AndingDrLin/TDPS/docs/line_following.md

# 巡线子系统设计（line_follow_v1）

本文档描述当前仓库中巡线系统的实现方案。重点是“为什么这样做”和“代码边界在哪里”。

## 1. 设计目标

- 在常见扰动下保持持续压线
- 丢线后可恢复，不进入无限振荡
- 关键参数可集中调节
- 可通过离线场景批量回归

## 2. 关键实现

### 2.1 传感器处理

- 传感器数量：8 路（默认）
- 输入模式由 `sensor_input_mode` 选择，支持 ADC、GPIO 数字量和 Yahboom 8-LP UART 协议路径
- 先做归一化，再做低通滤波
- 采用配置权重计算位置偏差；debug profile 因 Yahboom UART 实车通道顺序使用 `{1750..-1750}` 权重，方向以实车架空验证为准
- 输出辅助信号：`signal_sum`、`peak_value`、`contrast_value`、`active_count`、`line_confidence`、`edge_hint`

与 Yahboom 8-LP 的接口匹配策略：

- UART 模式：当前默认 debug profile 使用 `LF_SENSOR_INPUT_UART_PROTOCOL`。
- GPIO 模式：通过 `LF_SENSOR_INPUT_DIGITAL_GPIO` 读取 8 路高低电平。
- ADC 模式：保留 `LF_SENSOR_INPUT_ANALOG_ADC` 路径。
- 极性通过配置解决：
	- `sensor_digital_active_high`（数字模式）
	- `sensor_invert_polarity`（模拟/UART 归一化后翻转）

相关文件：

- `Src/lf_sensor.c`
- `Inc/lf_sensor.h`
- `Src/lf_config.c`（权重和阈值）

### 2.2 控制器

- 控制器类型：**PD + 曲率前馈(kff)**（`TDPS_SIMPLE_CONTROL=1`，6 参数）
- 核心公式：`correction = kp*error + kd*derivative + kff*derivative*speed`
- 速度公式：`speed = base_speed - (base_speed - min_speed) * |error| / 1750`（连续函数 + IIR 平滑 alpha=0.4）
- 底盘命令：`left = speed + correction`，`right = speed - correction`
- `correction > 0` 时左轮更快、右轮更慢，车向右修正；`correction < 0` 时向左修正
- 对输出和电机命令做限幅，避免打满
- 与旧架构差异：无死区/软区/积分/速度缩放/变化率限幅/二重滤波；速度由连续函数决定而非 6 级优先级链

相关文件：

- `Src/lf_control.c`
- `Src/lf_chassis.c`

### 2.3 状态机

状态定义：`WAIT_START -> CALIBRATING -> RUNNING -> RECOVERING / AVOID_* -> STOPPED`

核心行为：

- `CALIBRATING`：左右摆动采样，提高 min/max 覆盖度
- `RUNNING`：按固定周期读传感器 + 更新 PD + kff（简化模式）
- `RUNNING`：连续速度函数自动调节快慢（straight_boost/curve_prepare 已关闭）
- `RUNNING`：识别直线脏点、地图褶皱和反光造成的弱异常帧，通过 `straight_noise_*` 避免误触发弯前减速
- `RUNNING`：识别宽黑、T 字、直角、圆形入口、U 型顶点等特殊线型，通过 `lead_compensation` 先低速直行补偿，再按入口方向保持转向
- `RUNNING`：识别宽黑/箭头类干扰帧，避免单帧跳变污染恢复方向或立即触发岔路
- `RUNNING`：并行轮询雷达状态（非阻塞），`WARN` 减速，`BLOCK` 进入避障
- `RECOVERING`：按可信的最后看到线方向搜索；若遇到 `BLOCK` 也进入避障
- `AVOID_*`：停车确认、转出、弧线绕行、转回、低速找线；失败后反向重试
- 超时或重试失败进入 `STOPPED`，避免失控持续运行

相关文件：

- `Src/lf_app.c`
- `Inc/lf_app.h`

## 3. 参数策略

参数集中在 `Src/lf_config.c` 的 `g_lf_config`。当前实车默认启动路径会调用 `LF_Config_ApplyDebugProfile()`，所以上板低速验证以 `Src/lf_config_profiles.c` 的 debug profile 覆盖值为准；默认结构体值主要作为未套 profile 或 competition profile 的基线。逐项含义和整车调试方法见 `docs/tuning.md`。

建议顺序：

1. 传感器极性、通道顺序和 `sensor_weights`
2. 6 核心参数：`base_speed` → `kp` → `kd` → `kff` → `min_speed` → `max_correction`
3. `straight_noise_*`
4. `lead_advance_ticks`
5. `lead_turn_delta` / `lead_turn_hold_ticks`
8. `lead_event_confirm_ticks` / `lead_event_min_sum` / `lead_event_active_count_threshold`
9. `line_detect_min_sum` / `line_detect_min_peak` / `line_detect_min_contrast`
10. `interference_active_count_threshold` / `interference_position_jump_threshold`
11. `line_hold_speed` / `line_hold_turn_speed` / `recover_timeout_ms`
12. `obstacle_turn_out_ms` / `obstacle_bypass_ms` / `obstacle_turn_in_ms`
13. `obstacle_reacquire_timeout_ms` / `obstacle_preferred_side`

8-LP 相关关键参数：

- `sensor_input_mode`
- `sensor_digital_threshold`
- `sensor_digital_active_high`
- `sensor_invert_polarity`
- `sensor_use_dynamic_calibration`

调参要求：

- 一次只改少量参数
- 每次改动记录场景、参数、结果
- 调参结论以离线报告为准，不靠主观印象

## 4. 离线回归方法

默认场景配置：`simulator/sim_tests/line_follow_v1/config/scenarios_default.csv`

覆盖类型：

- 基线场景（circle/figure8/patio）
- 初始偏置（left/right offset）
- 传感器噪声、掉线、增益/偏置误差
- 电机不一致、一阶惯性、低速非线性、电池压降
- 传感器安装偏差、线宽变化
- 雷达延迟、漏检、误检、距离抖动
- 组合压力场景

门禁规则由 harness 固化：

- quick：`82 / 0.94 / 0.35 / min_scenario_score=70`
- full-course：完整赛道需按顺序触发检查点、到达终点、无碰撞/越界，并满足进度与丢线门限
- stability：`80 / 93% / 0.40s`

当前 track 相关 quick 回归结果：手动用当前 `simulator/` 路径构建 runner 后，`quick` normal 16 个场景整体 `95.41/100`、平均检测率 `100.00%`、最大丢线 `0.000s`、Confidence `High`。注意：部分脚本仍引用旧 `TDPS-Simulator/` 路径，必要时按 `agent_docs/03_agent_working_notes.md` 说明手动使用当前路径。

## 5. 扩展接口

`lf_future_hooks` 提供弱符号空实现，用于后续接入：

- LoRa 窗口触发
- 雷达窗口触发
- 标定开始/结束事件
- 丢线/复线事件

约束：扩展逻辑不得直接破坏 `LF_App_RunStep` 的周期语义。

## 6. 已知限制

- 当前三轮差速车传感器阵列中心到左右驱动轮轴线中点约 22 cm，左右驱动轮中心距约 16 cm；路口、U 型顶点、直角和圆形入口应以驱动轮轴线中点作为实际转向参考点
- `lead_advance_ticks` 目前是时间近似，不是编码器闭环距离；换速度、电池、电机或地面摩擦后，需要重新校准“传感器看到特殊线型后继续前进多远”
- 雷达解析已支持保留测试帧、LD2410S 最小帧和已知标准帧目标/距离字段，仍需实机确认距离单位、波特率和目标状态语义
- 当前避障只有前向雷达信息，不能直接感知障碍在左侧还是右侧；左右绕行依赖配置、上次线方向和失败反向重试
- 避障动作是定时开环，换电池、电机、地面摩擦或车体负载后必须重新调参
- `LF_Config_ApplyDebugProfile()` 是默认启动配置，使用低速保守参数；`LF_Config_ApplyCompetitionProfile()` 仅在明确切换时用于比赛参数。
