AndingDrLin/TDPS/reports/final_report/team_15_final_pre.pdf

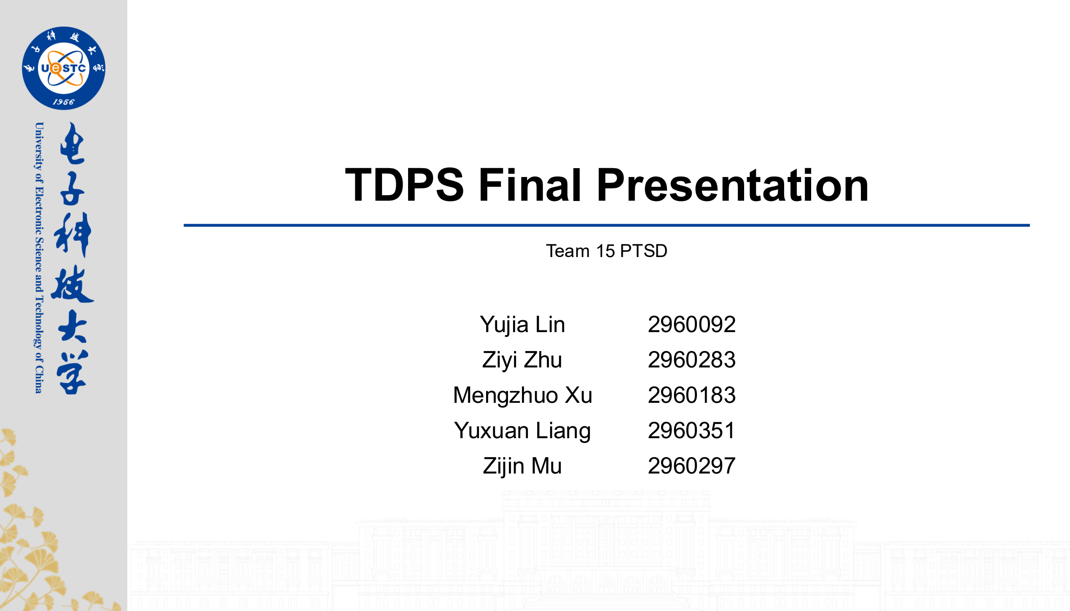
[picture p1: page 1]

# TDPS Final Presentation

Yujia Lin | 2960092
Ziyi Zhu | 2960283
Mengzhuo Xu | 2960183
Yuxuan Liang | 2960351
Zijin Mu | 2960297

Team 15 PTSD

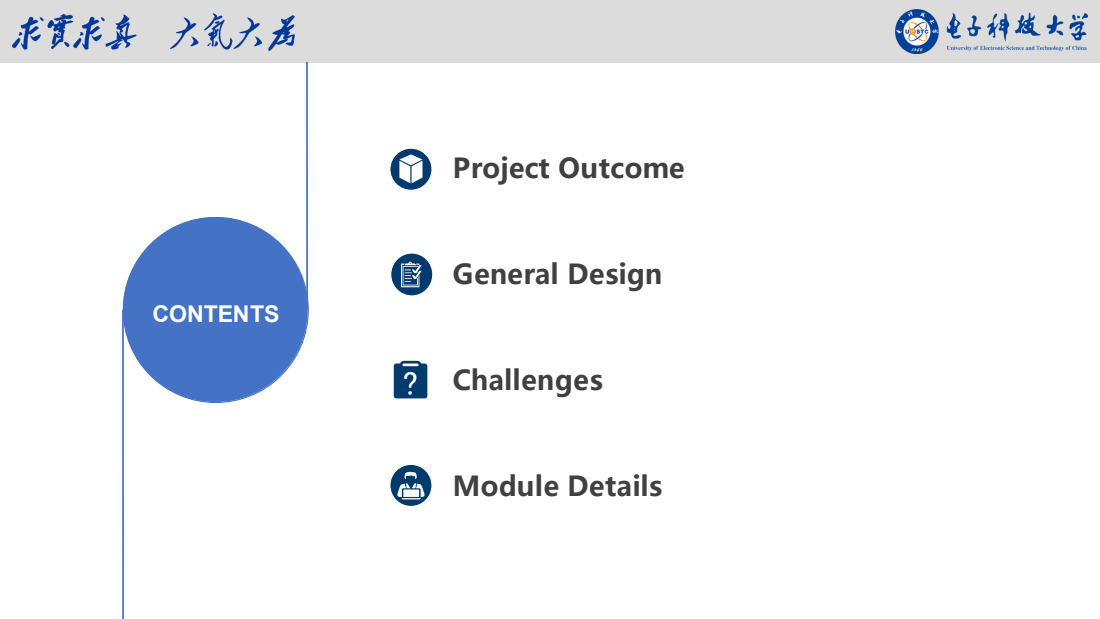
[picture p2: page 2]
CONTENTS; General Design; Project Outcome; Challenges; Module Details

# Project Outcome

## Final Demo Results:

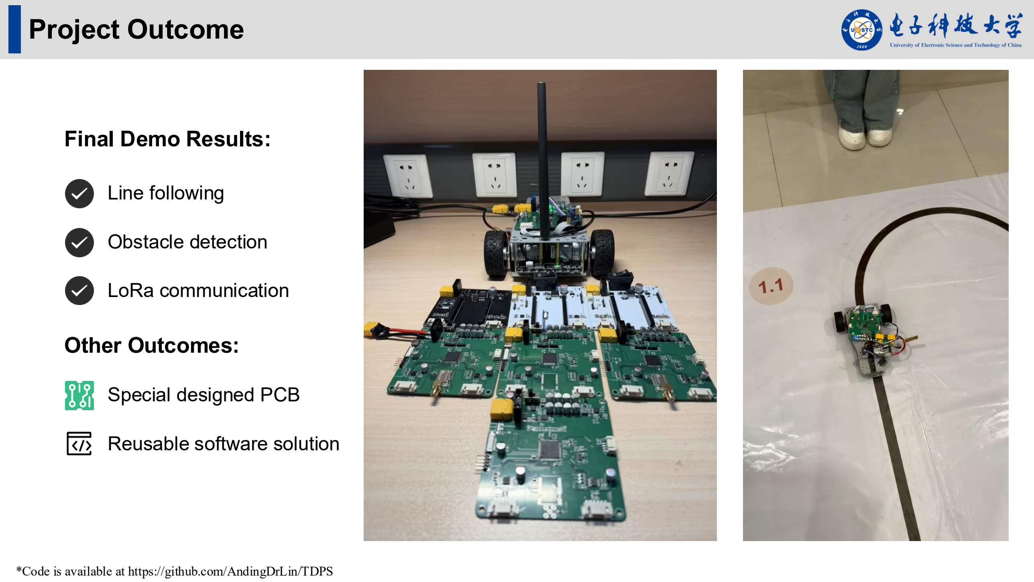
[picture p3: page 3]

## Line following

## Obstacle detection

## LoRa communication

## Other Outcomes:

## Special designed PCB

## Reusable software solution

*Code is available at https://github.com/AndingDrLin/TDPS

# Hardware Platform

## Chassis Selection:

## - Differential tricycle: easy to design and test

## - Inverted tricycle: more flexible but not stable

## - Forward tricycle: very hard to finish line following

## PCB Design:

- Adapter board: easy to design,

## low reliability, problems with power supply

- Integrated PCB: much smaller,

## more stable, much better power supply

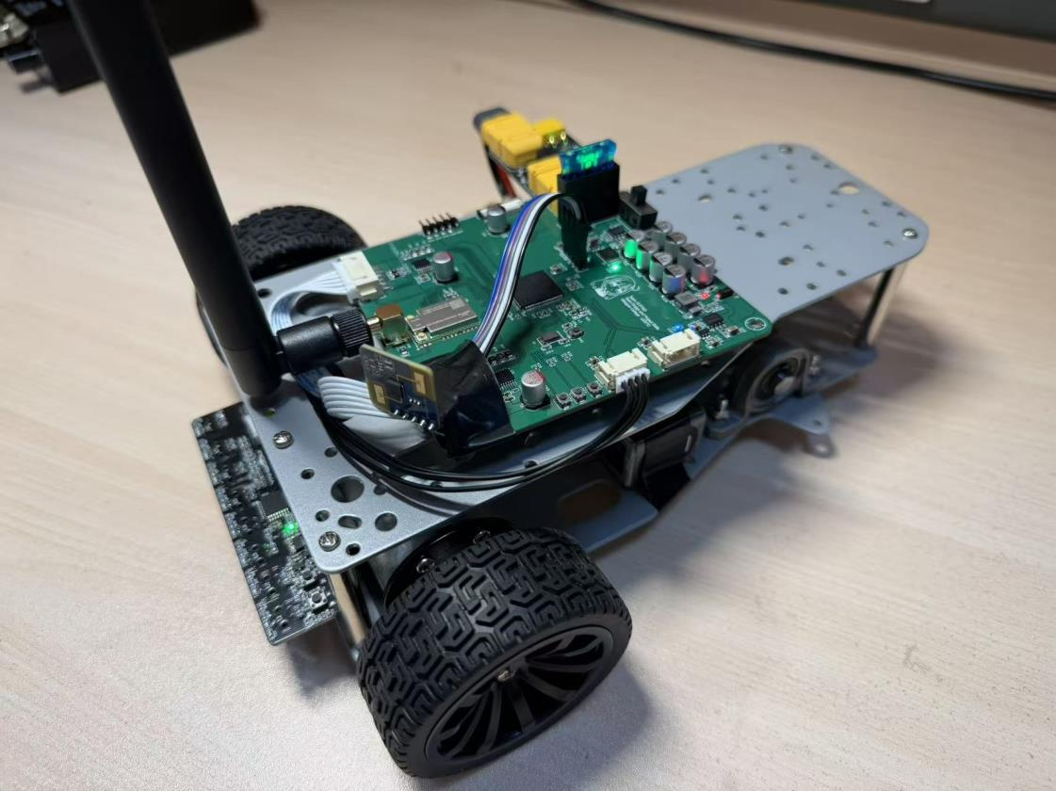
[picture p4: figure]

Module | Type
Line-following Sensor | Yahboom 8-LP Sensor
LoRa Module | EWT22A-900BWL22S
Radar | HLK-LD2410S
MCU | STM32F407VET6

## Software Architecture

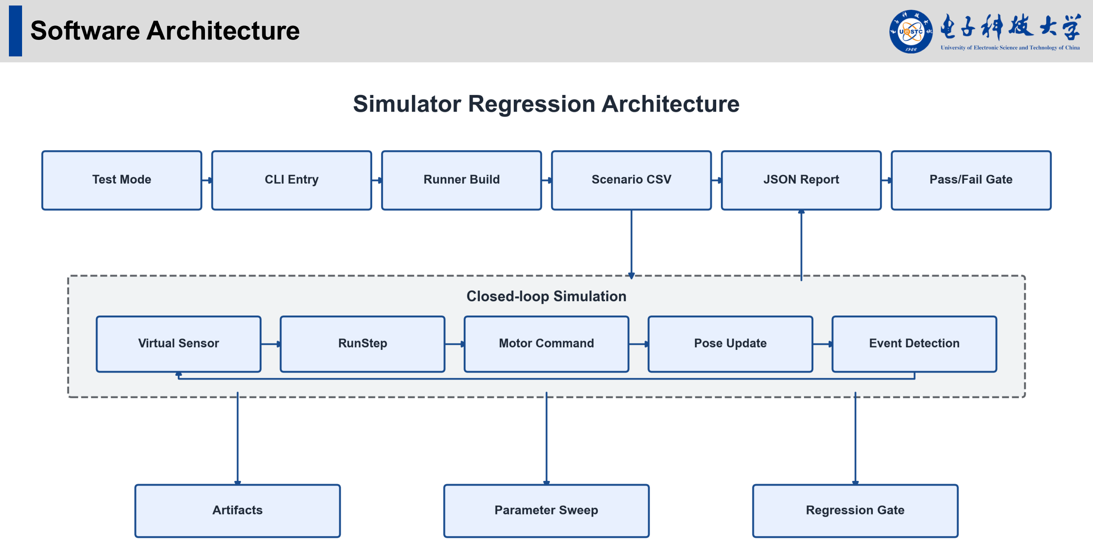
[picture p5: page 5]

## Challenges and Insight

## Challenges:

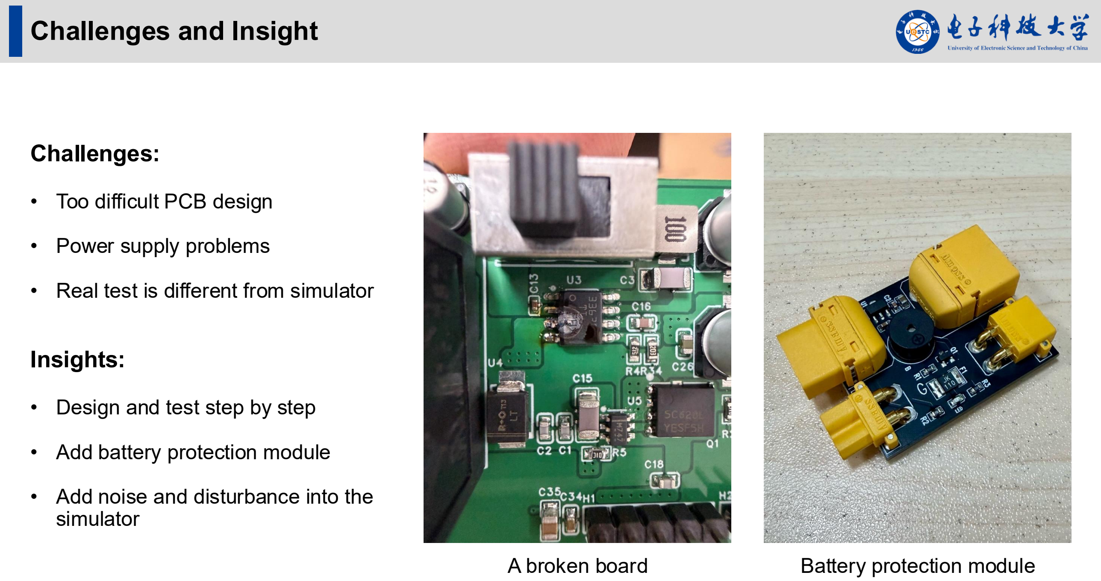
[picture p6: page 6]

## - Too difficult PCB design

## - Power supply problems

## - Real test is different from simulator

## Insights:

## - Design and test step by step

## - Add battery protection module

## - Add noise and disturbance into the simulator

A broken board | Battery protection module

## Core Requirements

## ① Design Objective

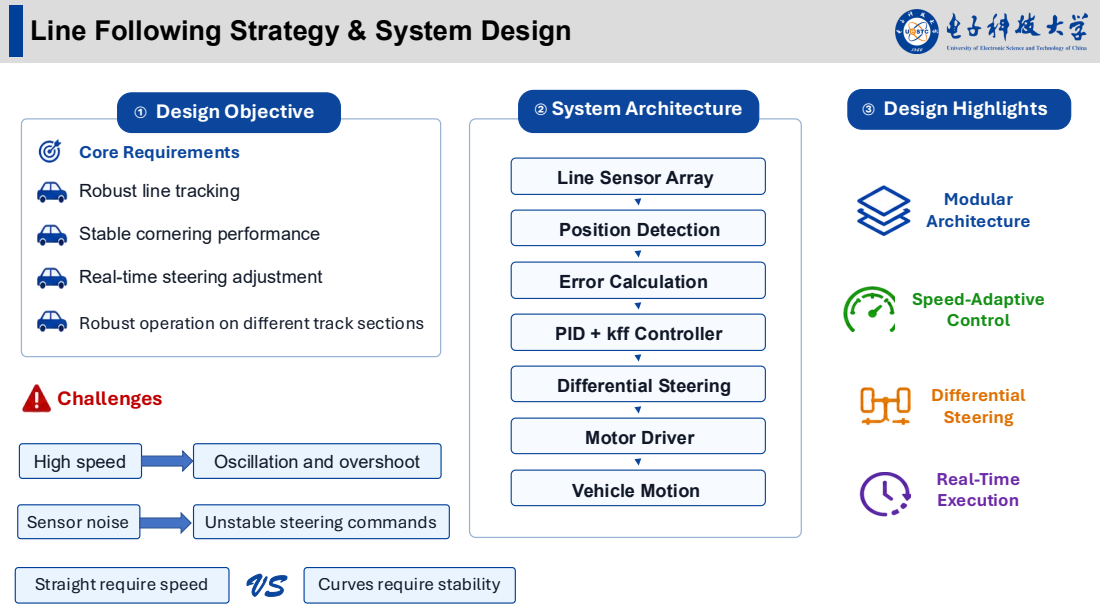
[picture p7: page 7]
Challenges; High speed; Sensor noise; ② System Architecture; Position Detection; Error Calculation; Differential Steering; Motor Driver; Vehicle Motion; ③ Design Highlights; Modular Architecture; Speed-Adaptive Control; Real-Time Execution

Line Following Strategy & System Design

Line Sensor Array

Robust line tracking

Stable cornering performance

Real-time steering adjustment
Robust operation on different track sections

PID + kff Controller

Oscillation and overshoot

Unstable steering commands

Straight require speed

Curves require stability

# PD+kff Control Implementation

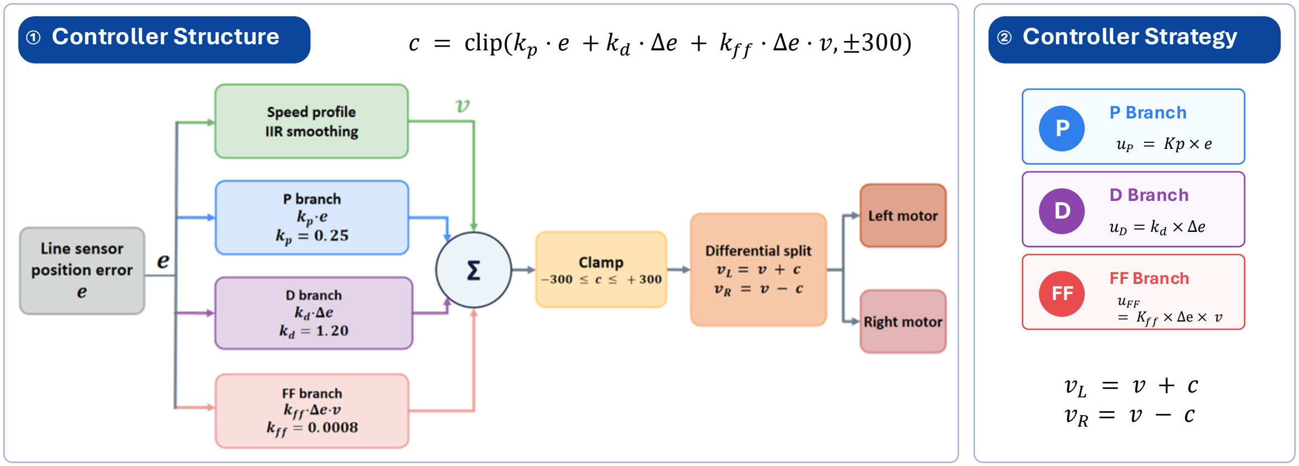
[picture p8: figure]
P Branch; D Branch; FF Branch; uFF = Kff × Δe × v

① Controller Structure | ② Controller Strategy

## c = clip(kp · e + kd · Δe + kff · Δe · v, ±300)

## ③ Why PD+kff ?

Control Method | Characteristics
P Only | Fast but oscillatory
PD | Stable but slower
PD+kff | Fast and stable

Achieved Benefits

✓ Reduced oscillation

✓ Faster response

✓ Smooth cornering

✓ Stable high-speed line tracking

## NON-BLOCKING TECHNICAL ROUTE

# Radar Subsystem: Technical Route & Architecture

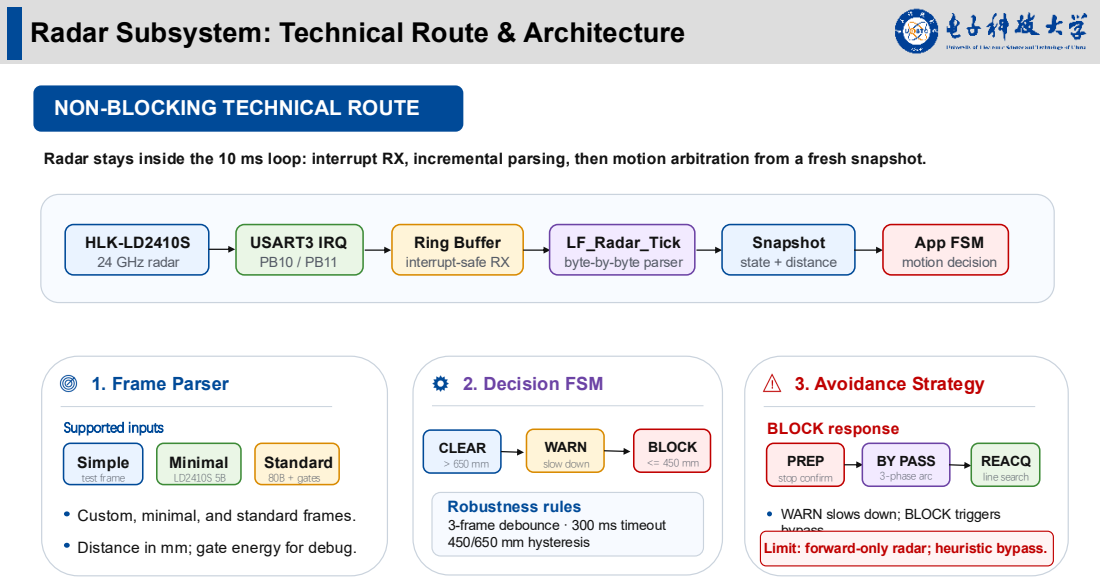
[picture p9: page 9]
HLK-LD2410S; 24 GHz radar; USART3 IRQ; Snapshot; state + distance; App FSM; motion decision; 1. Frame Parser; Supported inputs; Simple test frame; Minimal LD2410S 5B; Standard 80B + gates; 2. Decision FSM; CLEAR > 650 mm; WARN slow down; BLOCK <= 450 mm; 3. Avoidance Strategy; BLOCK response; PREP stop confirm; BY PASS 3-phase arc; REACQ line search

Radar stays inside the 10 ms loop: interrupt RX, incremental parsing, then motion arbitration from a fresh snapshot.

Ring Buffer
interrupt-safe RX

LF_Radar_Tick
byte-by-byte parser

Robustness rules
3-frame debounce · 300 ms timeout
450/650 mm hysteresis

WARN slows down; BLOCK triggers
bypass.
Limit: forward-only radar; heuristic bypass.

Custom, minimal, and standard frames.

Distance in mm; gate energy for debug.

# PCB Integration: Power and Interfaces

# Initial PCB Design:

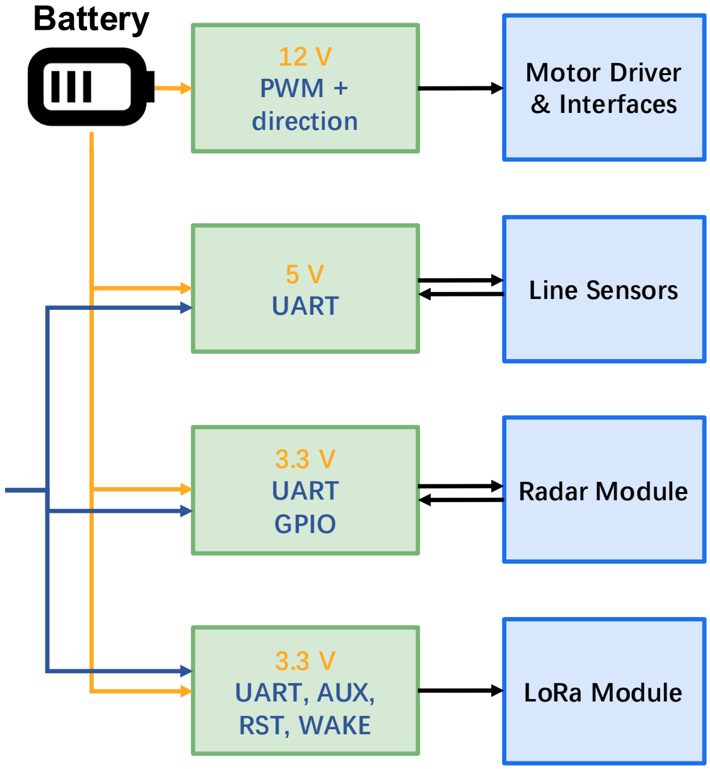
[picture p10: figure]
Motor Driver & Interfaces; Line Sensors; Radar Module; LoRa Module; 12 V PWM + direction; 5 V UART; 3.3 V UART GPIO; 3.3 V UART, AUX, RST, WAKE; Battery

## Adapter board + STM32F407VET6

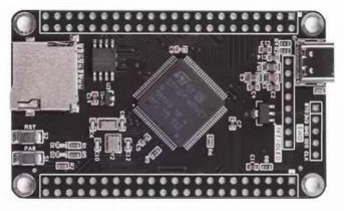
[picture p11: figure]

+

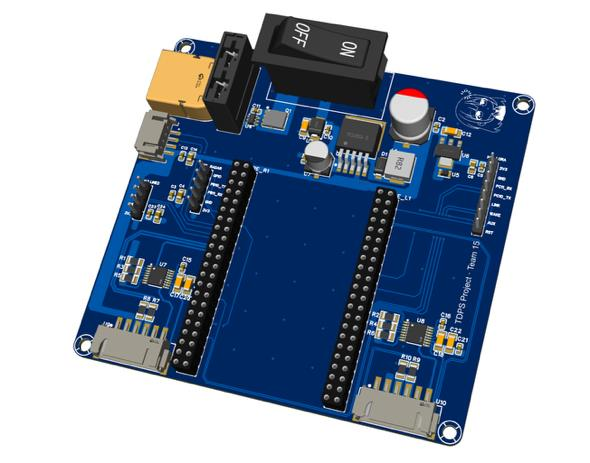
[picture p12: figure]

Limitation:

Loose and unreliable wiring | Poor power stability

## MCU

# Requirement Analysis

# PCB : Six Iterations to PCB6

# Different Versions and Iterations of PCB Design

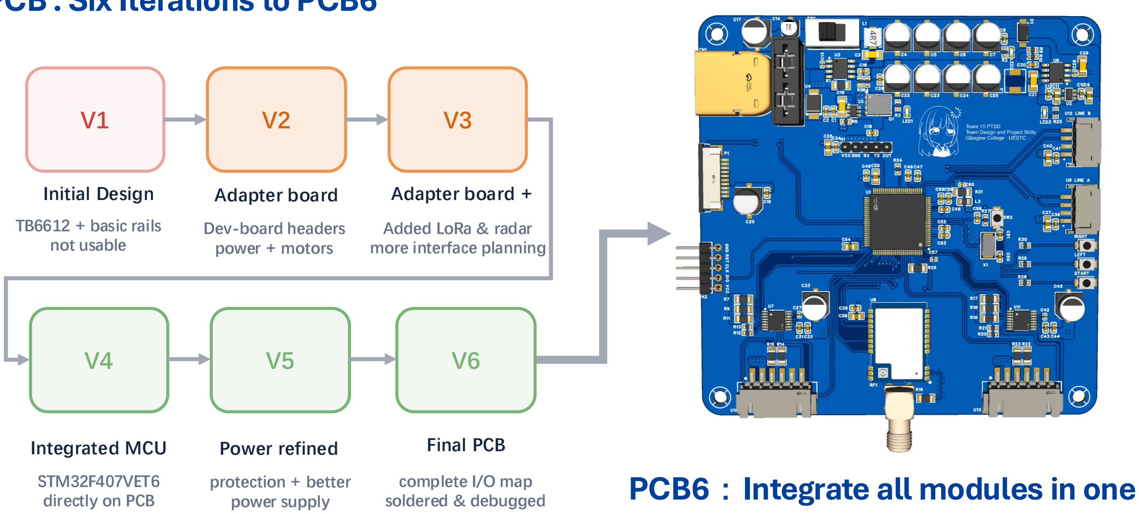
[picture p13: figure]
Adapter board; Dev-board headers power + motors; Added LoRa & radar more interface planning; STM32F407VET6 directly on PCB; complete I/O map soldered & debugged; Initial Design; TB6612 + basic rails not usable; Adapter board +; Integrated MCU; Power refined; protection + better power supply; Final PCB; PCB6：Integrate all modules in one

### Battery input and protection

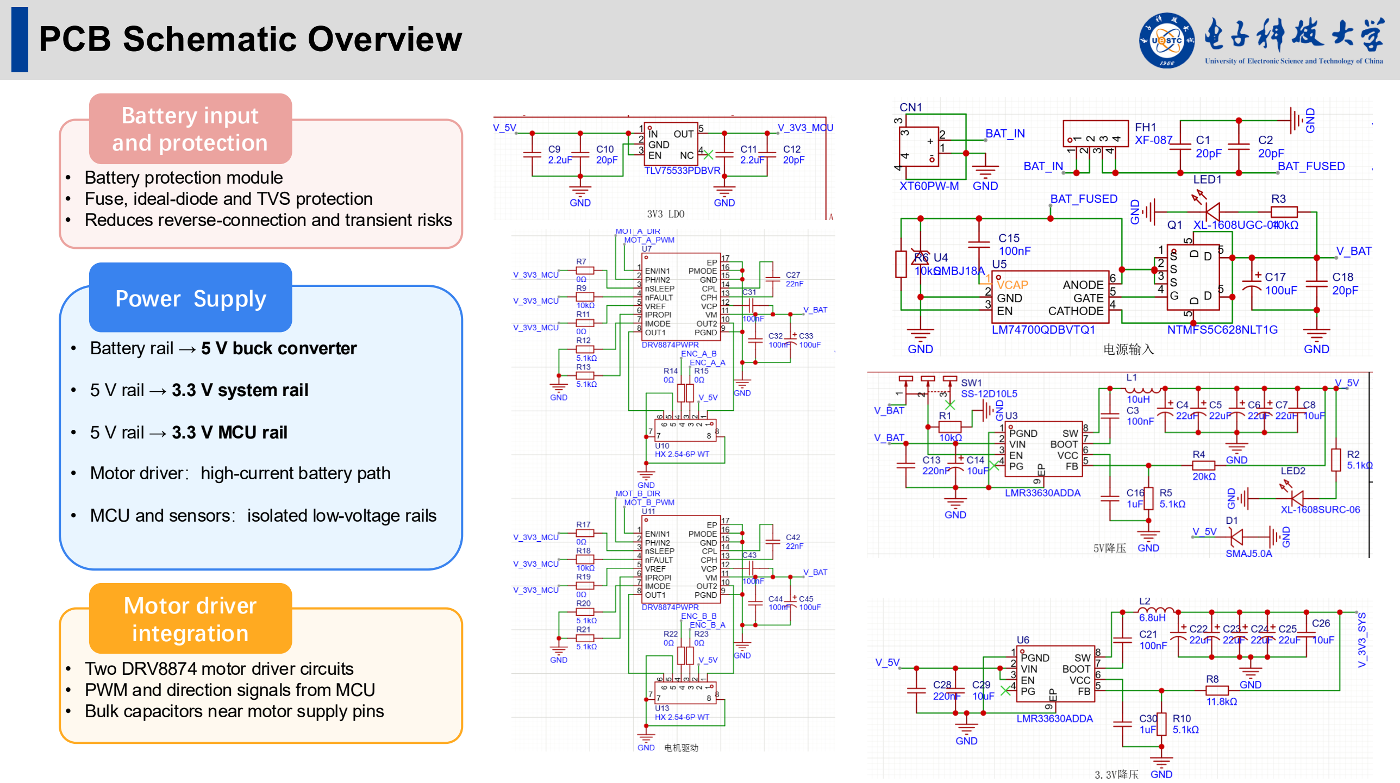
[picture p14: page 12]

- Battery protection module
- Fuse, ideal-diode and TVS protection
- Reduces reverse-connection and transient risks
- Battery rail → 5 V buck converter
- 5 V rail → 3.3 V system rail
- 5 V rail → 3.3 V MCU rail
- Motor driver：high-current battery path
- MCU and sensors：isolated low-voltage rails
- Two DRV8874 motor driver circuits
- PWM and direction signals from MCU
- Bulk capacitors near motor supply pins

### Power Supply

### Motor driver integration

# PCB Schematic Overview

## Requirement Analysis

## Initial Design (Version 1)

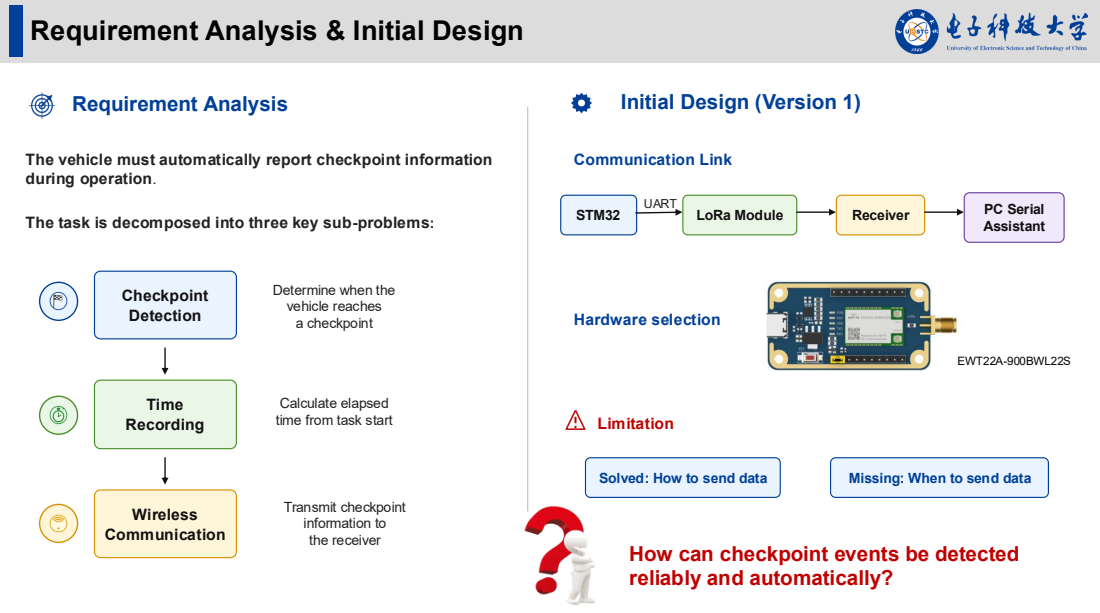
[picture p15: page 13]
Time Recording; Wireless Communication; Transmit checkpoint information to the receiver; Checkpoint Detection; Communication Link; Hardware selection; STM32; UART; LoRa Module; Receiver; PC Serial; Assistant; EWT22A-900BWL22S; Limitation; Solved: How to send data; Missing: When to send data

Requirement Analysis & Initial Design

The vehicle must automatically report checkpoint information
during operation.

The task is decomposed into three key sub-problems:

Determine when the
vehicle reaches
a checkpoint

Calculate elapsed
time from task start

How can checkpoint events be detected
reliably and automatically?

Version 2 | Version 3

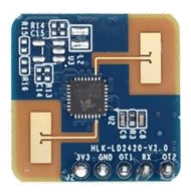
[picture p16: figure]

## Problems

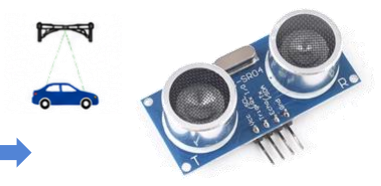
[picture p17: figure]

HLK-LD2410S-24G | HC-SR04

Detects front obstacles only

Cannot detect overhead checkpoint gates

Unable to provide a reliable trigger event

Detects overhead structures

Provides clear checkpoint trigger

Simple integration with STM32

## Advantages

Right Sensor

Reliable Trigger

Simple Implementation

## Key Considerations

# Design Evolution & Technical Decisions

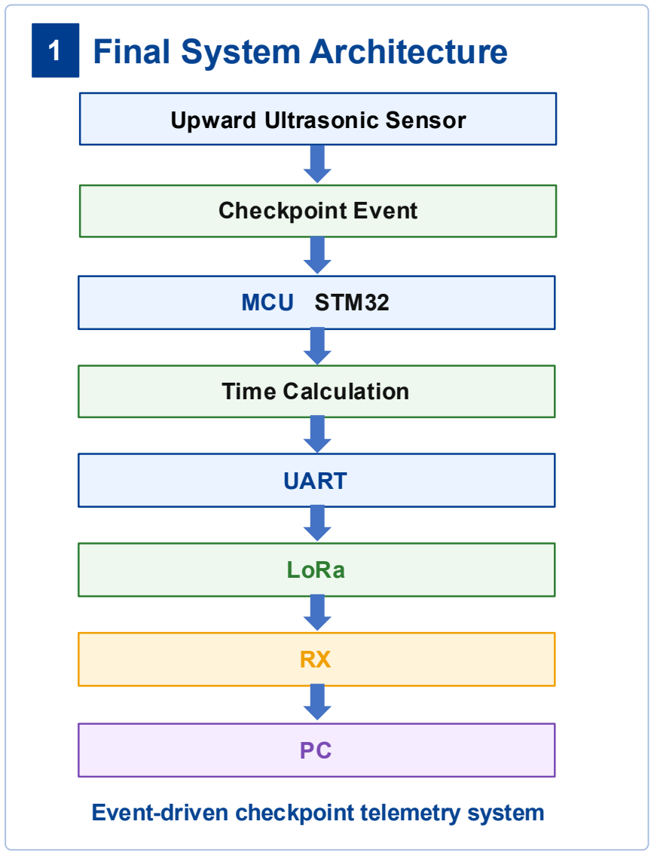
[picture p18: figure]
1 Final System Architecture; Upward Ultrasonic Sensor; Checkpoint Event; MCU STM32; Time Calculation; UART; LoRa; Event-driven checkpoint telemetry system

## 2 Event Handling Strategy

After checkpoint detection, the system processes the event in a fixed sequence:

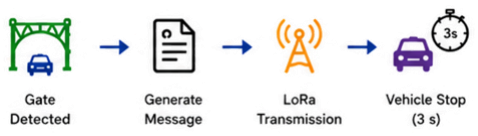
[picture p19: figure]

## Why Stop?

✓ Avoid repeated triggering

✓ Stable event processing

✓ Easy communication verification

# Final Implantation & Tests

## Example Output

Team 15 PTSD
Duration 01:23 8:00

Team 15 PTSD
Duration 01:34 8:00

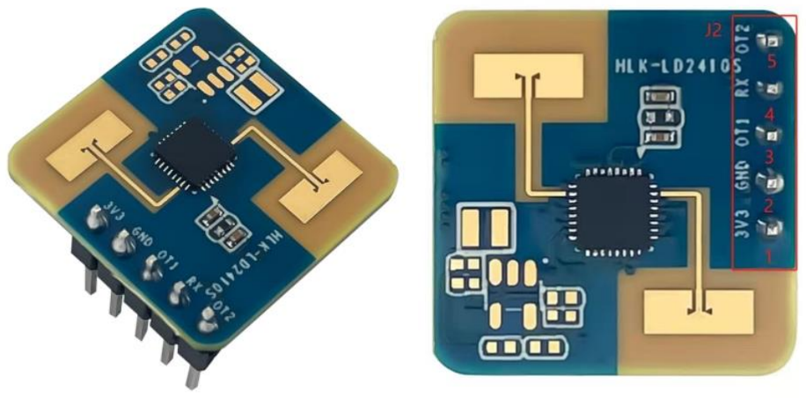
[picture p20: figure]

### 01. Solution Selection and Core Advantages

Core Component: HLK-LD2410S 24GHz Millimeter Wave Radar

- Strong Environmental Adaptability : Unaffected by light, temperature,

dust, stable outdoors.

- Abundant Resources : More comprehensive docs than CYPLUS radar.

### 02. Standalone Radar Testing

Used manufacturer’s PC software (HLK-LD2410S_TOOL) to verify radar

works

The software clearly displays:

Whether a target is present, distance vs. time curve, power vs. range gate curve

Solution for Inaccuracy (< 0.35m) : Use "presence/absence" judgment (no

precise distance needed).

Radar module appearance

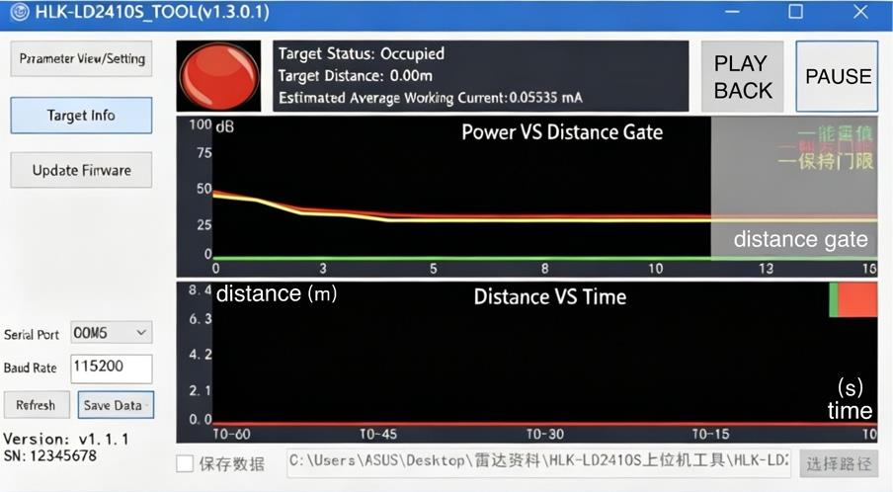
[picture p21: figure]

PC software

# Radar Obstacle Avoidance Subsystem

### 03. Radar-to-MCU Communication Verification

Debugging: 4 LEDs verify communication/parsing.

LED1: Radar powered on

LED2: Radar sending data to STM32

LED3: Obstacle detected

LED4: STM32 decided to turn to clear side

### 04. Achievement Summary

System Status

The radar module works stably, detecting obstacles in real-time and

reliably.

Project Contribution

Successfully implemented autonomous obstacle avoidance,

completing the project satisfactorily.

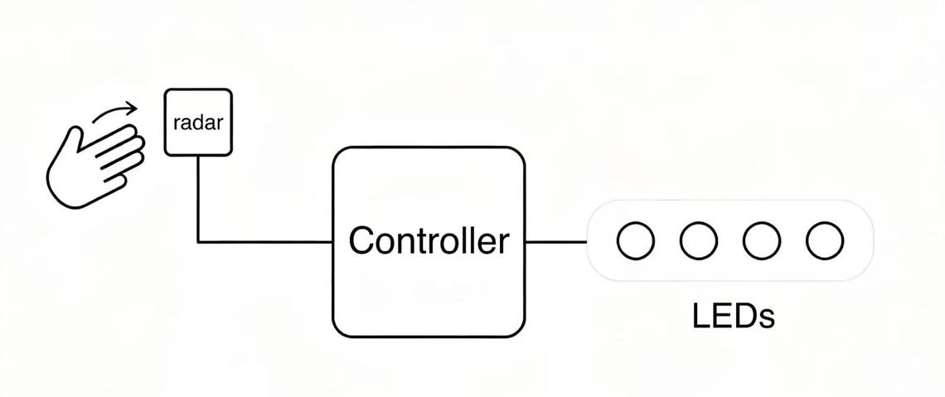
[picture p22: figure]

LEDs testing schematic diagram

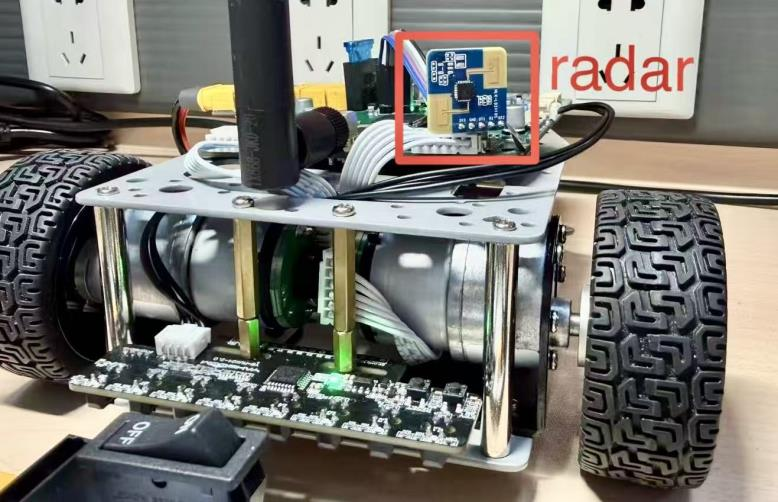
[picture p23: figure]

Radar installed on vehicle

# Radar Obstacle Avoidance Subsystem

## Mechanical Design & Sensor

# Line Following Sensor

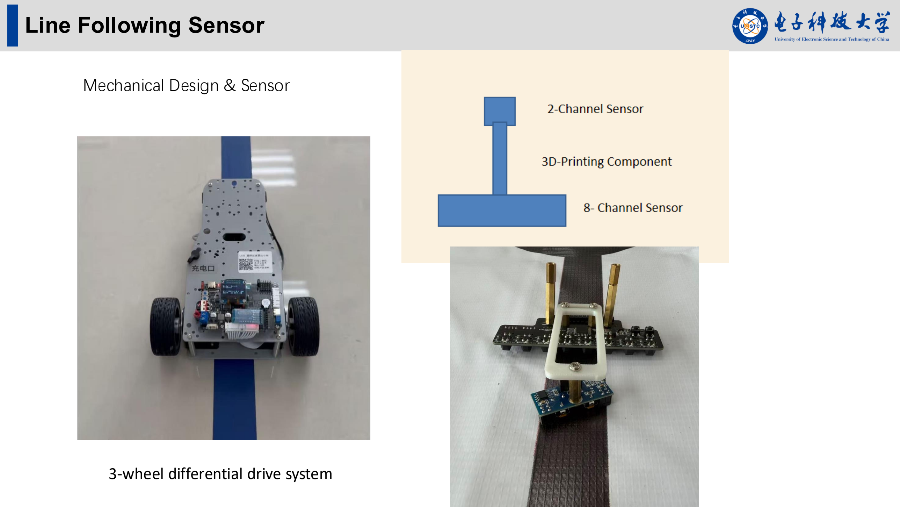
[picture p24: page 18]

## 3-wheel differential drive system

16 cm

22cm

3cm

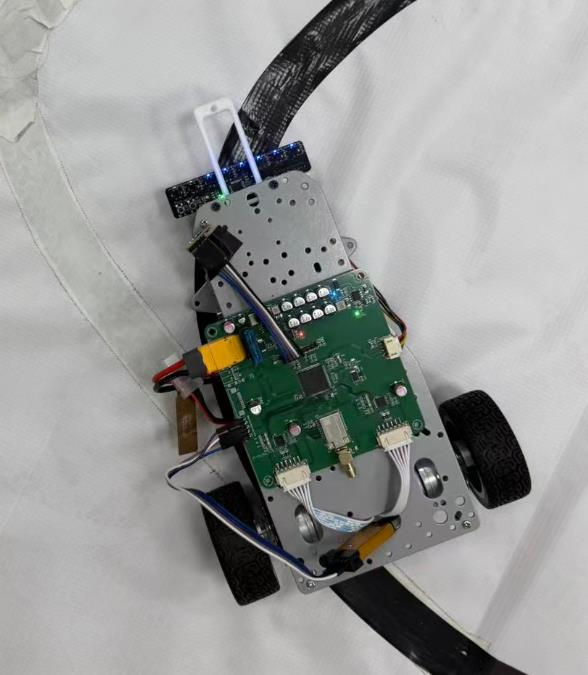
[picture p25: figure]
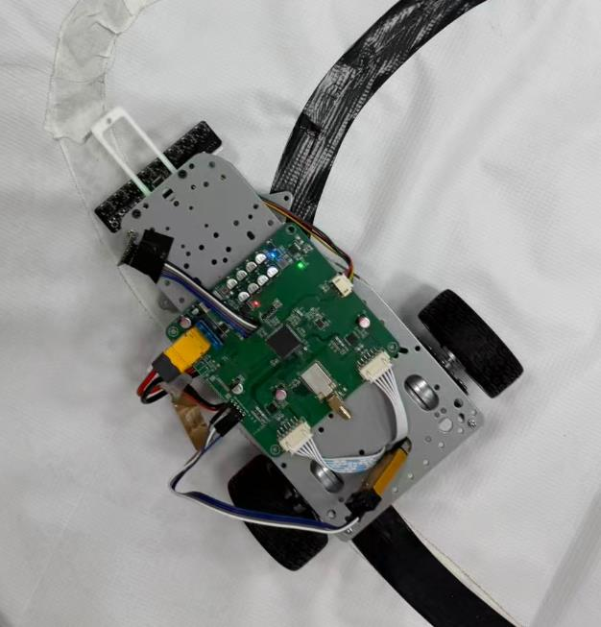
[picture p26: figure]

# “tiny correction at the 16cm-spaced wheels caused the front sensor to swing violently across the track”

# New problem

# Line Following Sensor

# Part2: Individual Presentation

Some Problems......

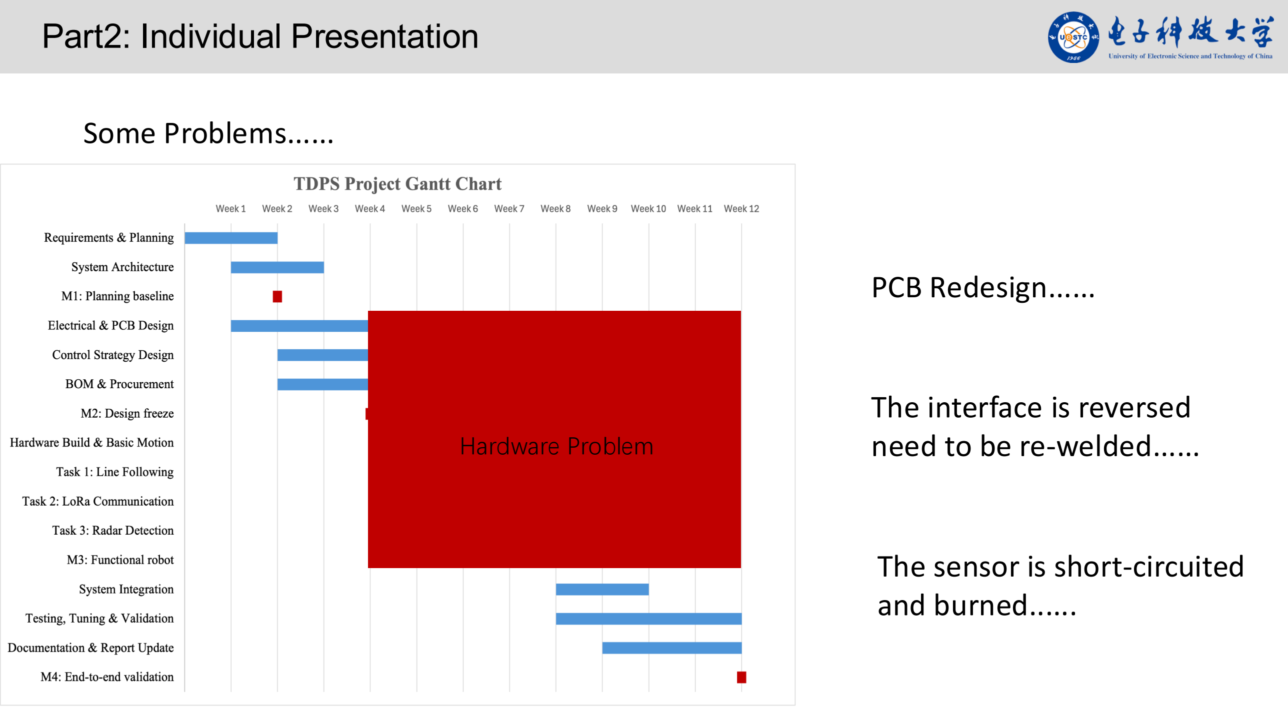
[picture p27: page 20]

## Hardware Problem

PCB Redesign......

# The interface is reversed

need to be re-welded......

# The sensor is short-circuited

and burned......

# Conclusion

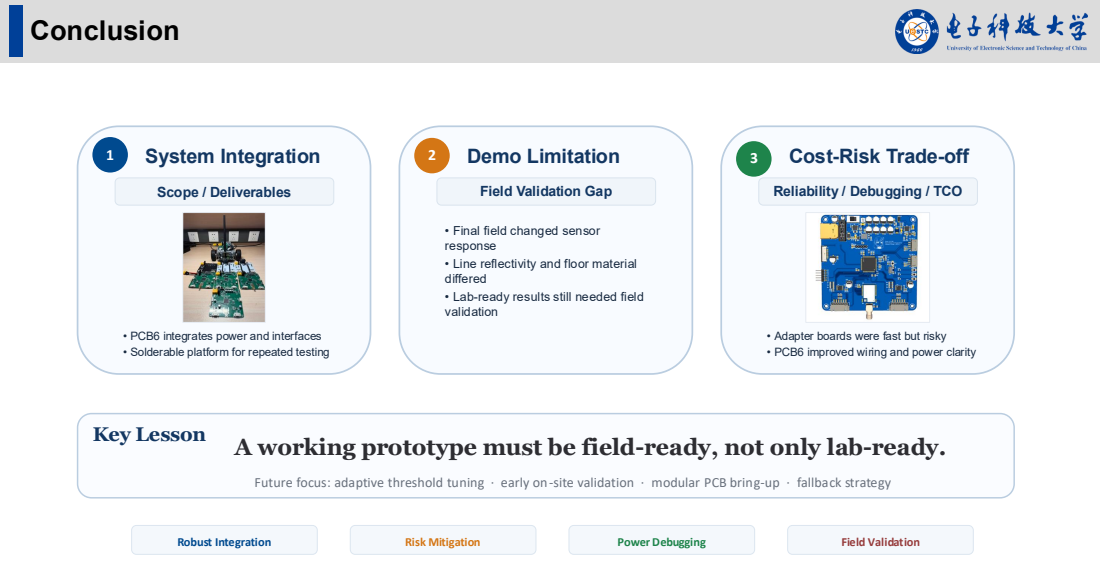
[picture p28: page 21]
1 System Integration; Scope / Deliverables; 2 Demo Limitation; Key Lesson; A working prototype must be field-ready, not only lab-ready.; Robust Integration; Risk Mitigation; Power Debugging; Field Validation

3 Cost-Risk Trade-off

Field Validation Gap

Reliability / Debugging / TCO

• Final field changed sensor
response
• Line reflectivity and floor material
differed
• Lab-ready results still needed field
validation

• PCB6 integrates power and interfaces
• Solderable platform for repeated testing

• Adapter boards were fast but risky
• PCB6 improved wiring and power clarity

Future focus: adaptive threshold tuning · early on-site validation · modular PCB bring-up · fallback strategy

# Thanks for listening

## Team 15
