AndingDrLin/TDPS/reports/final_report/src/figures/fig1_architecture.pdf

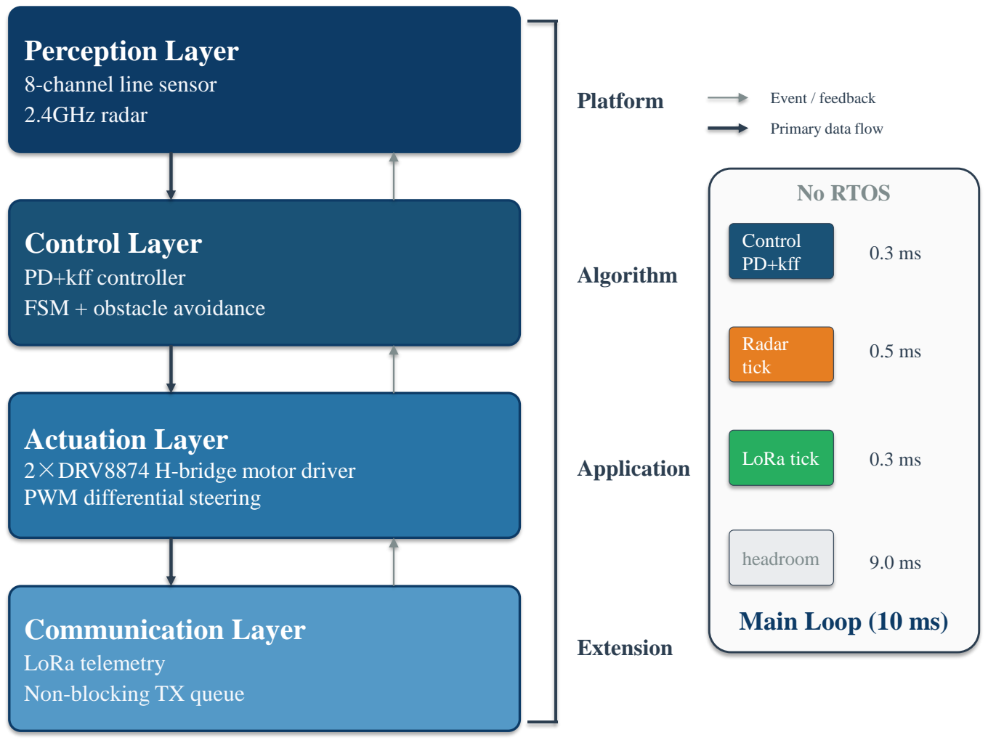
[picture p29: page 1]

### Communication Layer

LoRa telemetry
Non-blocking TX queue

### Actuation Layer

2×DRV8874 H-bridge motor driver PWM differential steering

### Control Layer

PD+kff controller
FSM + obstacle avoidance

### Perception Layer

8-channel line sensor
2.4GHz radar

Extension

Application

Algorithm

Platform

Main Loop (10 ms)

Control
PD+kff | 0.3 ms

Radar
tick

0.5 ms

LoRa tick | 0.3 ms
headroom | 9.0 ms

No RTOS

Primary data flow

Event / feedback
