AndingDrLin/TDPS/reports/final_report/src/figures/fig8_avoidance.pdf

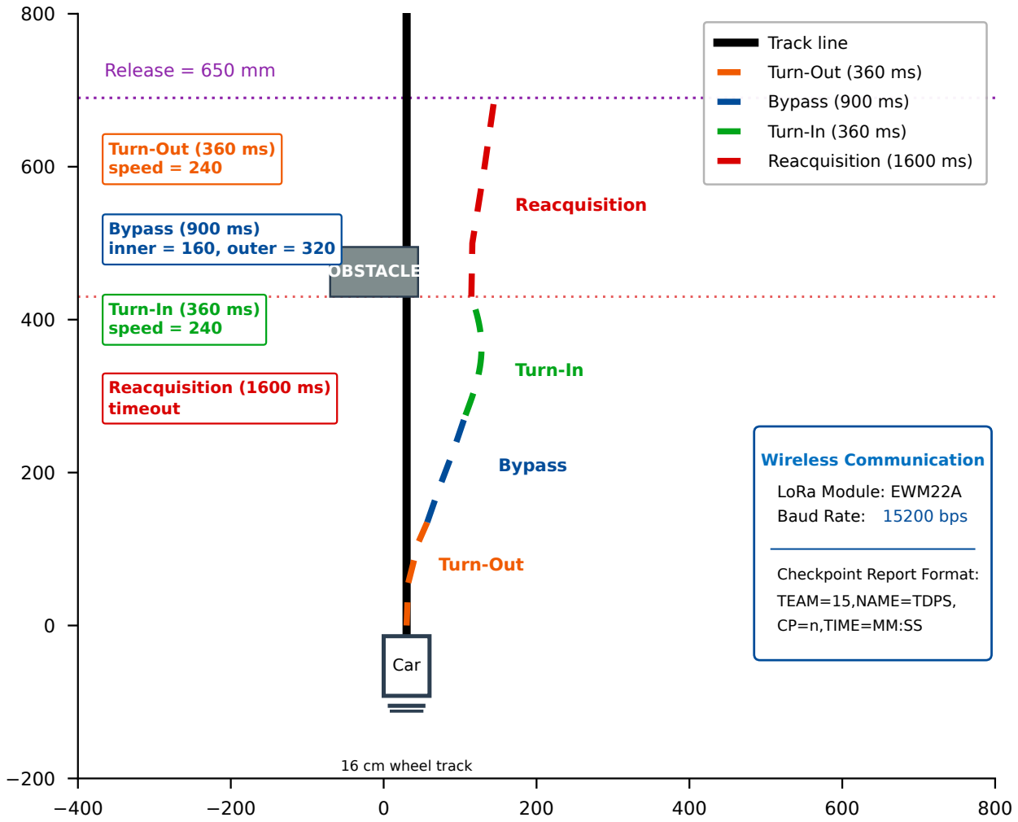
[picture p30: figure]
Release = 650 mm; 16 cm wheel track; Wireless Communication; LoRa Module: EWM22A Baud Rate: 15200 bps; Checkpoint Report Format:; TEAM=15,NAME=TDPS, CP=n,TIME=MM:SS; OBSTACLE; Track line; Turn-Out (360 ms); Bypass (900 ms); Turn-In (360 ms); Reacquisition (1600 ms); Car; Turn-Out (360 ms) speed = 240; Bypass (900 ms) inner = 160, outer = 320; Turn-In (360 ms) speed = 240; Reacquisition (1600 ms) timeout; Turn-Out; Bypass; Turn-In; Reacquisition

## X (mm)

## Y (mm)

Fig. 7. Open-loop avoidance maneuver trajectory with four phases (simulated).
