AndingDrLin/TDPS/reports/final_report/src/figures/fig9_lora_sequence.pdf

## LoRa Bounded-Trigger Communication Pipeline

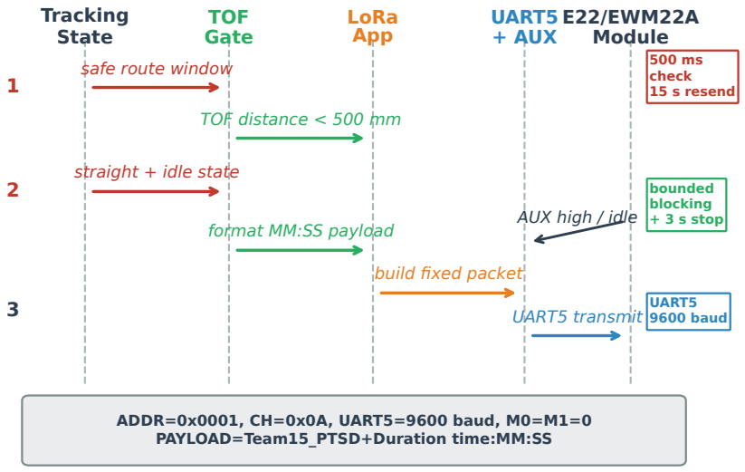
[picture p31: figure]
Tracking State; TOF Gate; LoRa App; UART5 + AUX; E22/EWM22A Module; safe route window; TOF distance < 500 mm; straight + idle state; format MM:SS payload; AUX high / idle; build fixed packet; UART5 transmit; 500 ms check 15 s resend; bounded blocking + 3 s stop; UART5 9600 baud; ADDR=0x0001, CH=0x0A, UART5=9600 baud, M0=M1=0 PAYLOAD=Team15_PTSD+Duration time:MM:SS
