AndingDrLin/TDPS/reports/final_report/src/figures/fig2_vehicle_photo.pdf

## [PHOTO: Vehicle Photo]

Replace this placeholder with a photograph of the assembled line-following robot. Suggested: top-down or 3/4 view showing sensor array, chassis, and motor configuration.
