AndingDrLin/TDPS/reports/final_report/src/figures/fig11_kff_sweep.pdf

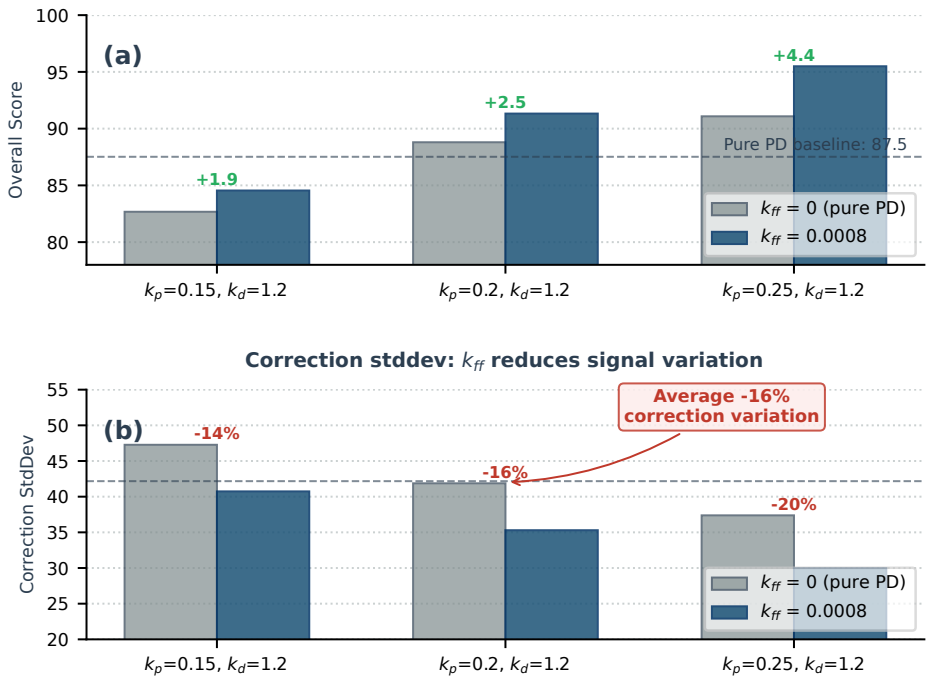
[picture p32: figure]
Overall Score; Pure PD baseline: 87.5; kff = 0 (pure PD) kff = 0.0008; Correction StdDev; Average -16% correction variation (b)

kp=0.15, kd=1.2 | Correction stddev: kff reduces signal variation | kp=0.2, kd=1.2 | kp=0.25, kd=1.2

### Overall score: kff = 0 vs kff = 0.0008
