AndingDrLin/TDPS/reports/final_report/src/figures/fig3_pcb.pdf

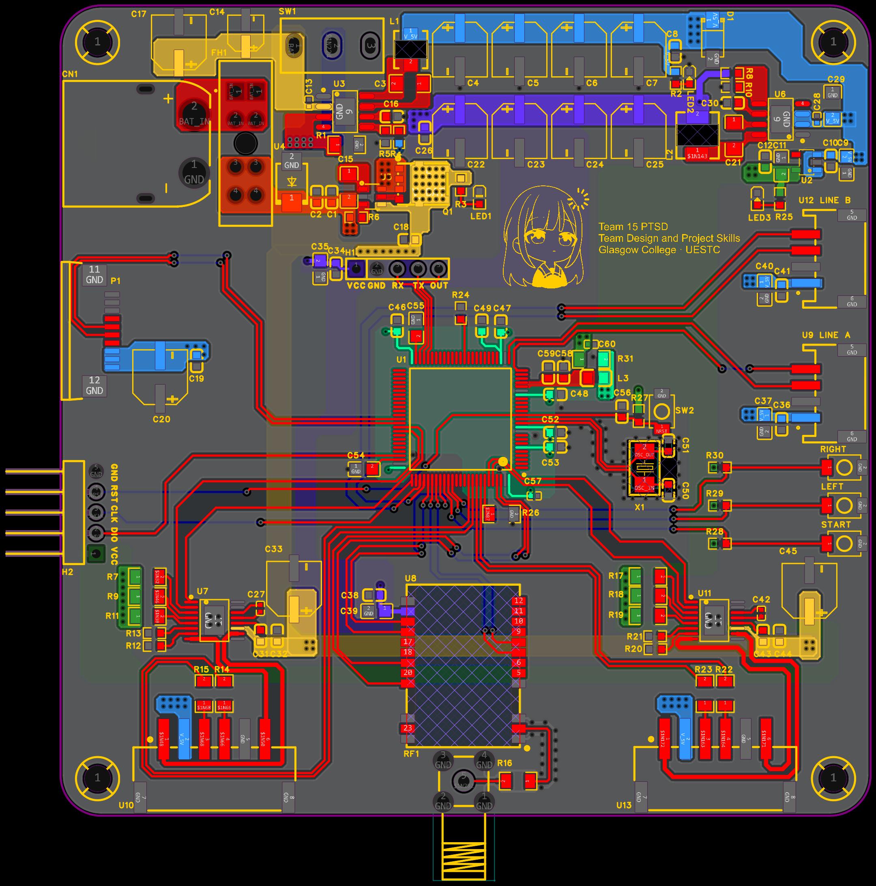
[picture p33: page 1]
