AndingDrLin/TDPS/reports/final_report/src/figures/fig3_schematic.pdf

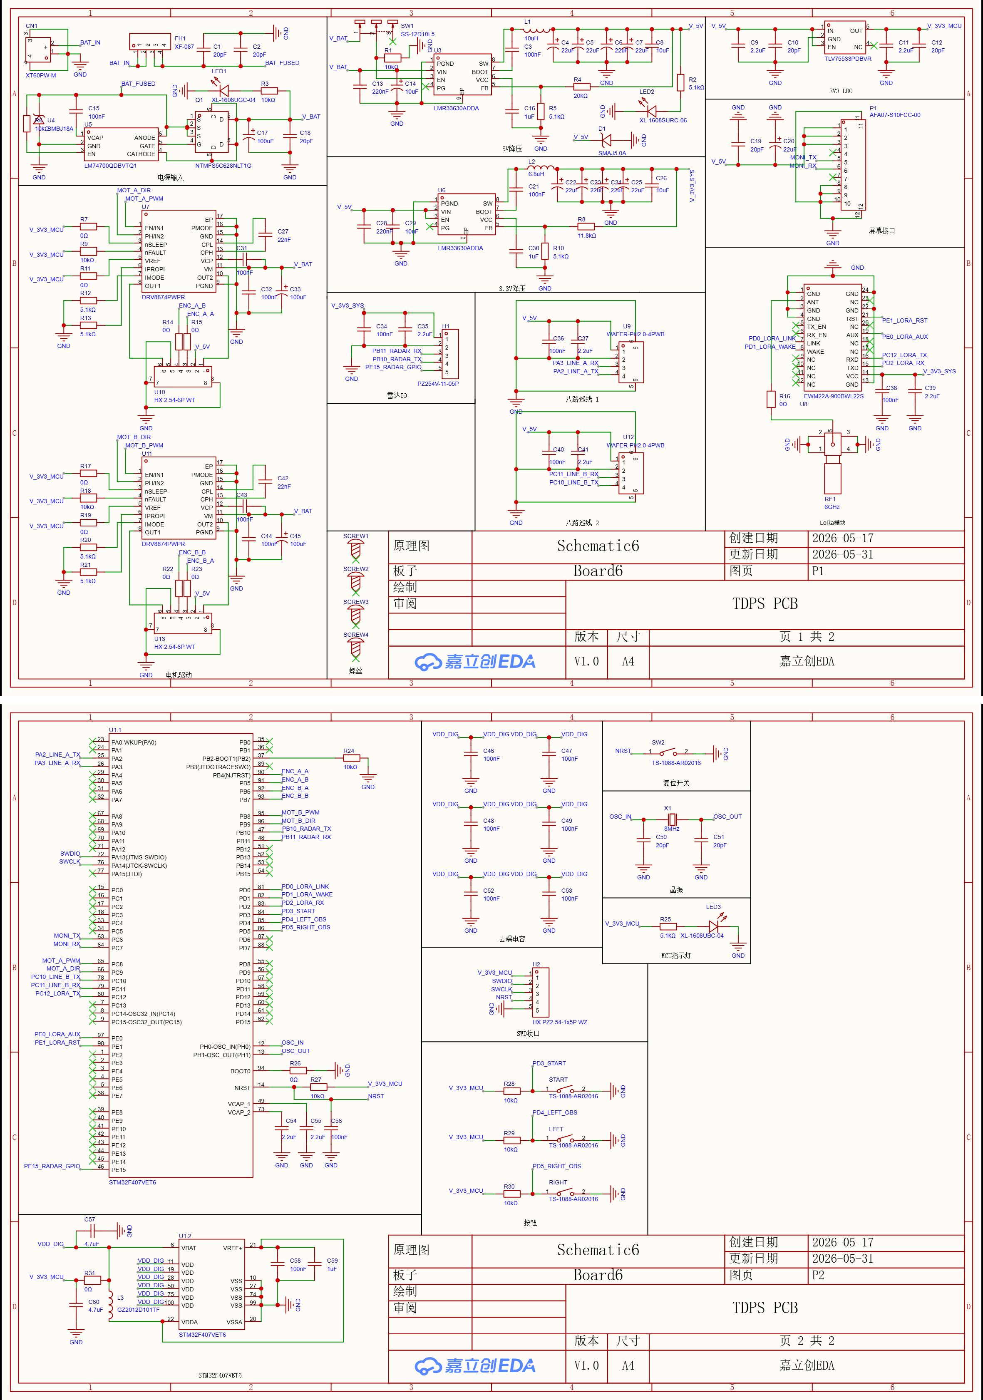
[picture p34: page 1]
