AndingDrLin/TDPS/reports/final_report/src/figures/fig3a_sch1.pdf

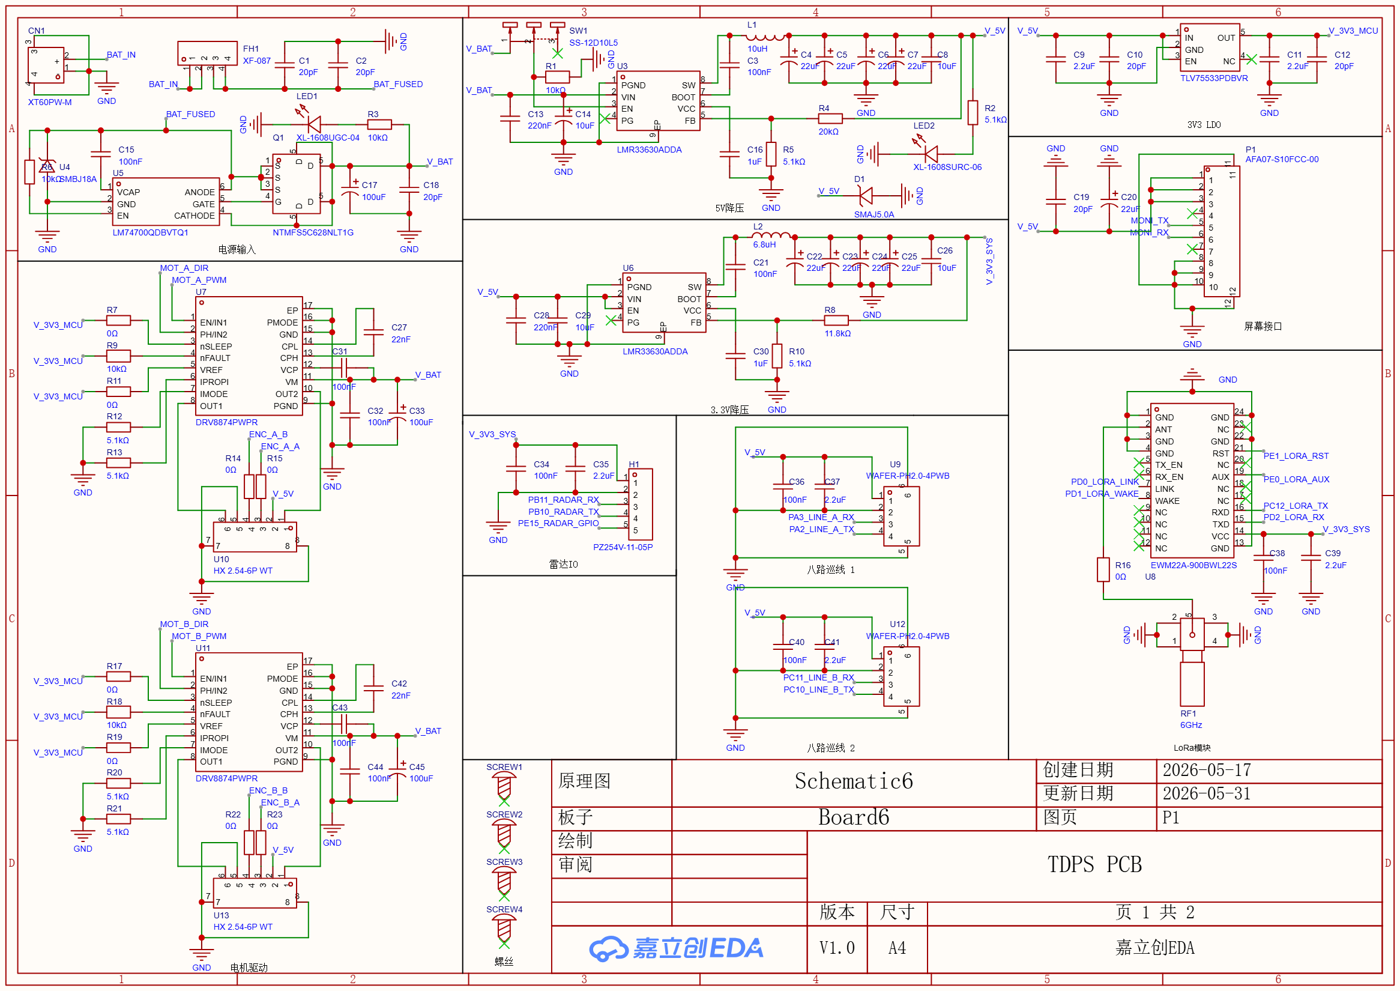
[picture p35: page 1]
