AndingDrLin/TDPS/reports/final_report/src/figures/fig3b_sch2.pdf

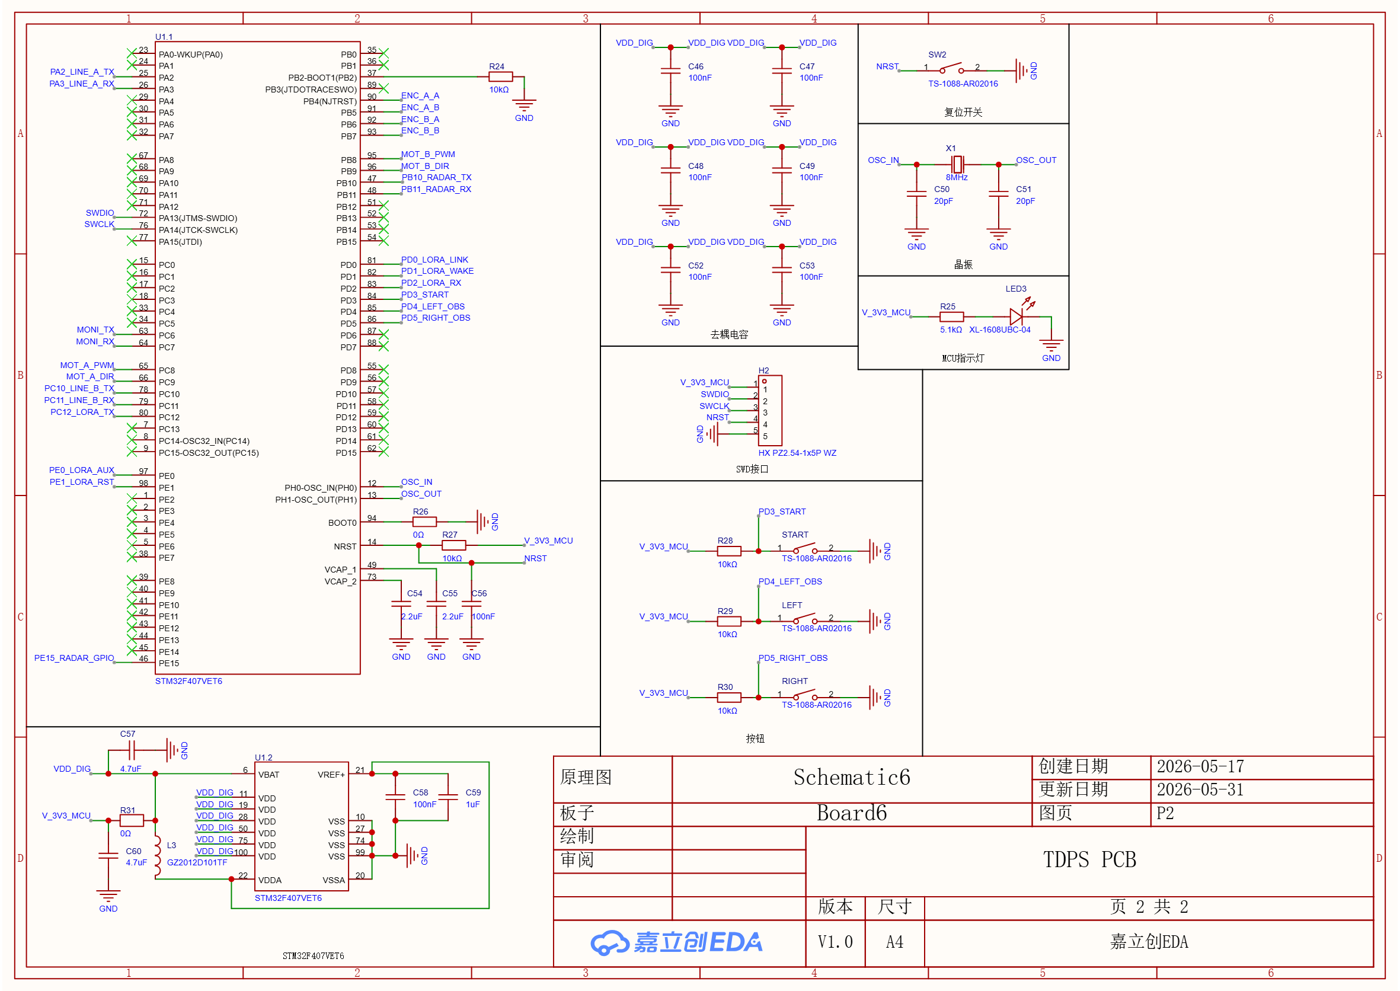
[picture p36: page 1]
