AndingDrLin/TDPS/reports/final_report/src/figures/fig5_timeline.pdf

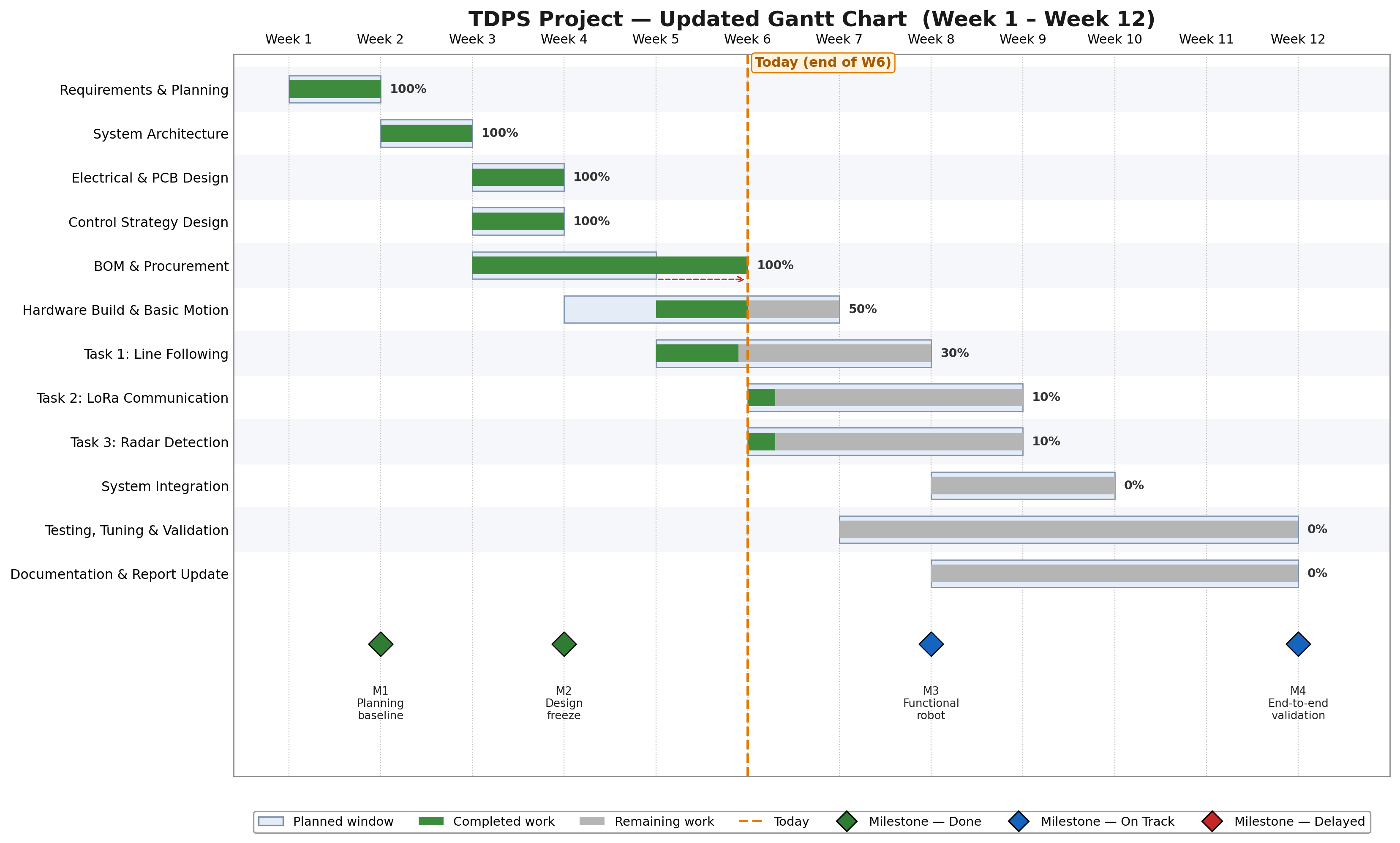
[picture p37: page 1]
