AndingDrLin/TDPS/TDPS/simulator/sim_tests/line_follow_v1/config/scenarios_sweep_coarse.csv

id | name | track | startX | startY | startTheta | noiseStd | dropoutProb | contrast | leftMotorScale | rightMotorScale | seed | radarEnable | obstacleMode | obstacleCount | obstacleSeed | checkpointEnable | checkpointExpectedCount | wirelessEnable | finishEnable | boundaryEnable
circle_baseline | Circle baseline | circle | 0.0 | 0.0 | 1.57079632679 | 0.005 | 0.000 | 1.00 | 1.00 | 1.00 | 101 | false | none | 0 | 0 | false | 0 | false | false | false
figure8_baseline | Figure8 baseline | figure8 | 0.0 | 0.0 | 1.57079632679 | 0.008 | 0.000 | 1.00 | 1.00 | 1.00 | 102 | false | none | 0 | 0 | false | 0 | false | false | false
