AndingDrLin/TDPS/reports/final_report/src/figures/fig6_control_block.pdf

v

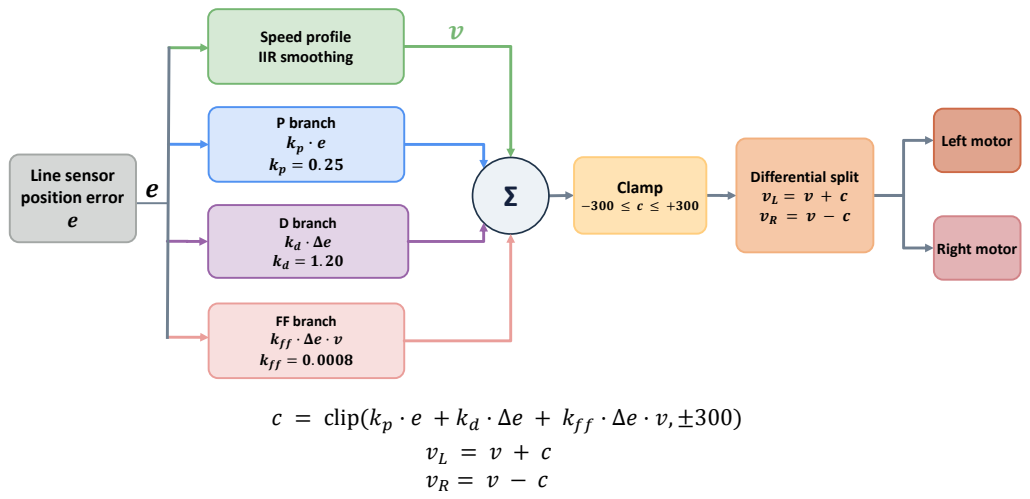
[picture p38: page 1]
Line sensor position error e; Speed profile IIR smoothing; P branch kp · e kp = 0. 25; D branch kd · Δe kd = 1. 20; FF branch kff · Δe · v kff = 0. 0008; Clamp; Differential split vL = v + c vR = v − c; Left motor; Right motor

c = clip(kp · e + kd · Δe + kff · Δe · v, ±300)
