AndingDrLin/TDPS/reports/final_report/src/figures/fig7_state_machine.pdf

## RUNNING CALIBRATING

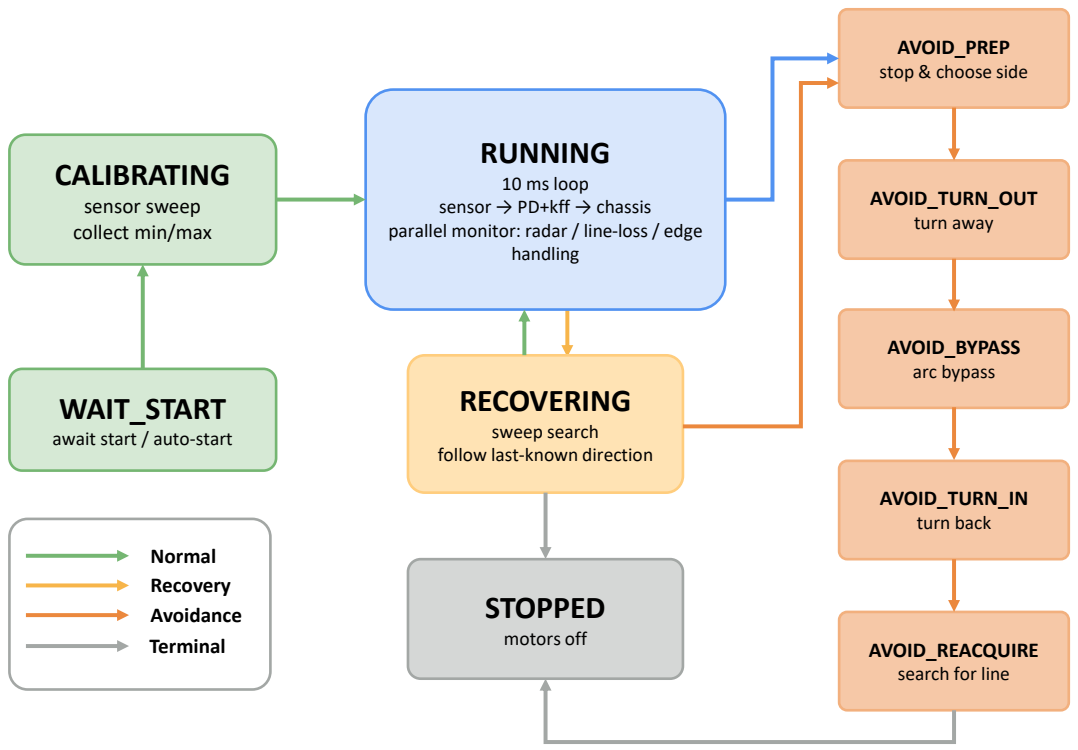
[picture p39: page 1]
10 ms loop; handling; STOPPED; motors off; AVOID_TURN_OUT turn away; AVOID_BYPASS arc bypass; AVOID_TURN_IN turn back; Normal Recovery Avoidance Terminal

AVOID_PREP
stop & choose side

sensor sweep
collect min/max

sensor → PD+kff → chassis
parallel monitor: radar / line-loss / edge

RECOVERING
sweep search
follow last-known direction

WAIT_START
await start / auto-start

AVOID_REACQUIRE
search for line
