AndingDrLin/TDPS/reports/final_report/src/figures/fig10_coarse_sweep.pdf

(a)

(b)

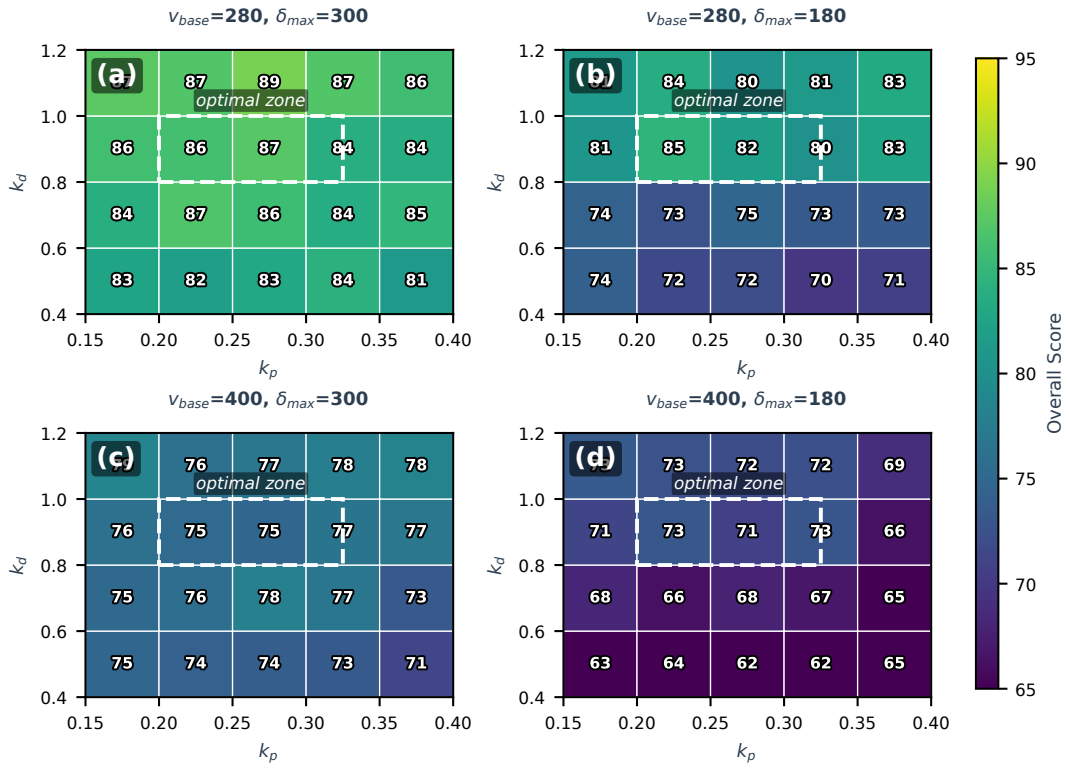
[picture p40: page 1]
vbase=280, δmax=300; optimal zone; vbase=280, δmax=180; vbase=400, δmax=300; vbase=400, δmax=180; Overall Score
