AndingDrLin/TDPS/TDPS/firmware/Src/wl_lora.c

/**
 * @file    wl_lora.c
 * @brief   EWM22A-900BWL22S LoRa driver layer implementation.
 *
 * Configures the module via AT commands and transmits data via UART.
 */

#include "wl_lora.h"
#include "wl_config.h"
#include "wl_platform.h"

#include <stdio.h>
#include <string.h>

/* ------------------------------------------------------------------ */
/*  Internal constants                                                 */
/* ------------------------------------------------------------------ */

/** Success keyword in AT command responses. */
#define AT_OK_TOKEN     "OK"

/** Temporary buffer sizes (for constructing AT commands and reading responses). */
#define CMD_BUF_SIZE    64
#define RESP_BUF_SIZE   128
#define DBG_BUF_SIZE    192
#define ACK_BUF_SIZE    32
#define ACK_TOKEN_UPPER "ACK"
#define ACK_TOKEN_LOWER "ack"
#define FIXED_FRAME_HEADER_SIZE 3U

typedef struct {
    uint8_t payload[WL_TX_PAYLOAD_MAX];
    uint16_t len;
} WL_TxItem;

typedef struct {
    WL_TxItem queue[WL_TX_QUEUE_SIZE];
    uint16_t head;
    uint16_t tail;
    uint16_t count;

    bool tx_active;
    bool current_sent;
    bool waiting_ack;
    bool ack_received;
    bool ack_enabled;

    WL_TxItem current;
    uint8_t retries_used;
    uint32_t tx_start_ms;
    uint32_t last_tx_ms;
    uint32_t last_success_ms;

    char ack_line[ACK_BUF_SIZE];
    uint8_t ack_line_len;

    WL_LoRa_LinkStatus link;
} WL_LoRaService;

static WL_LoRaService s_service;

static uint16_t service_queue_capacity(void)
{
    uint16_t cap = (uint16_t)g_wl_config.tx_queue_size;

    if (cap == 0U || cap > WL_TX_QUEUE_SIZE) {
        cap = WL_TX_QUEUE_SIZE;
    }
    return cap;
}

static void service_sync_link_snapshot(void)
{
    s_service.link.queue_depth = s_service.count;
    s_service.link.waiting_ack = s_service.waiting_ack;
    s_service.link.ack_enabled = s_service.ack_enabled;
}

static WL_LoRa_Status lora_send_payload(const uint8_t *data, uint16_t len)
{
    uint8_t frame[WL_UART_TX_BUF_SIZE];
    uint16_t dest_addr;

    if (g_wl_config.lora_trans_mode != 1U) {
        WL_Platform_UART_Send(data, len);
        return WL_LORA_OK;
    }

    if ((uint32_t)len + FIXED_FRAME_HEADER_SIZE > WL_UART_TX_BUF_SIZE) {
        return WL_LORA_ERR_PARAM;
    }

    dest_addr = g_wl_config.lora_fixed_dest_addr;
    frame[0] = (uint8_t)(dest_addr >> 8);
    frame[1] = (uint8_t)(dest_addr & 0xFFU);
    frame[2] = g_wl_config.lora_fixed_dest_channel;
    memcpy(&frame[FIXED_FRAME_HEADER_SIZE], data, len);
    WL_Platform_UART_Send(frame, (uint16_t)(len + FIXED_FRAME_HEADER_SIZE));
    return WL_LORA_OK;
}

static void service_reset_active_tx(void)
{
    s_service.tx_active = false;
    s_service.current_sent = false;
    s_service.waiting_ack = false;
    s_service.ack_received = false;
    s_service.retries_used = 0U;
    s_service.ack_line_len = 0U;
}

static void service_finish_success(void)
{
    s_service.link.tx_success_count += 1U;
    s_service.link.last_error = WL_LORA_OK;
    s_service.last_success_ms = WL_Platform_GetMillis();
    service_reset_active_tx();
    service_sync_link_snapshot();
}

static void service_finish_fail(WL_LoRa_Status err)
{
    s_service.link.tx_fail_count += 1U;
    s_service.link.last_error = err;
    service_reset_active_tx();
    service_sync_link_snapshot();
}

static bool service_pop_queue(WL_TxItem *out)
{
    uint16_t cap;

    if (out == NULL || s_service.count == 0U) {
        return false;
    }

    cap = service_queue_capacity();
    *out = s_service.queue[s_service.head];
    s_service.head = (uint16_t)((s_service.head + 1U) % cap);
    s_service.count -= 1U;
    service_sync_link_snapshot();
    return true;
}

static WL_LoRa_Status service_push_queue(const uint8_t *data, uint16_t len)
{
    uint16_t cap;

    if (data == NULL || len == 0U || len > WL_TX_PAYLOAD_MAX) {
        return WL_LORA_ERR_PARAM;
    }

    cap = service_queue_capacity();
    if (s_service.count >= cap) {
        s_service.link.queue_dropped += 1U;
        s_service.link.last_error = WL_LORA_ERR_BUSY;
        service_sync_link_snapshot();
        return WL_LORA_ERR_BUSY;
    }

    memcpy(s_service.queue[s_service.tail].payload, data, len);
    s_service.queue[s_service.tail].len = len;

    s_service.tail = (uint16_t)((s_service.tail + 1U) % cap);
    s_service.count += 1U;
    s_service.link.last_error = WL_LORA_OK;
    service_sync_link_snapshot();
    return WL_LORA_OK;
}

static void service_note_ack_line(void)
{
    s_service.ack_line[s_service.ack_line_len] = '\0';
    if (strstr(s_service.ack_line, ACK_TOKEN_UPPER) != NULL ||
        strstr(s_service.ack_line, ACK_TOKEN_LOWER) != NULL) {
        s_service.ack_received = true;
    }
    s_service.ack_line_len = 0U;
}

static void service_poll_rx(void)
{
    uint8_t rx[16];
    uint16_t n;

    do {
        uint16_t i;
        n = WL_Platform_UART_Receive(rx, (uint16_t)sizeof(rx));
        for (i = 0U; i < n; ++i) {
            uint8_t b = rx[i];

            if (b == (uint8_t)'\r' || b == (uint8_t)'\n') {
                if (s_service.ack_line_len > 0U) {
                    service_note_ack_line();
                }
                continue;
            }

            if (s_service.ack_line_len + 1U < ACK_BUF_SIZE) {
                s_service.ack_line[s_service.ack_line_len++] = (char)b;
            } else {
                s_service.ack_line[ACK_BUF_SIZE - 1U] = '\0';
                service_note_ack_line();
            }
        }
    } while (n > 0U);
}

static bool service_schedule_retry(uint32_t now_ms, WL_LoRa_Status reason)
{
    if (s_service.retries_used < g_wl_config.tx_retry_max) {
        s_service.retries_used += 1U;
        s_service.link.retry_count += 1U;
        s_service.current_sent = false;
        s_service.waiting_ack = false;
        s_service.ack_received = false;
        s_service.tx_start_ms = now_ms;
        s_service.ack_line_len = 0U;
        s_service.link.last_error = reason;
        service_sync_link_snapshot();
        return true;
    }

    service_finish_fail(reason);
    return false;
}

/* ------------------------------------------------------------------ */
/*  Waiting for AUX ready                                              */
/* ------------------------------------------------------------------ */

bool WL_LoRa_WaitAUX(uint32_t timeout_ms)
{
    uint32_t start = WL_Platform_GetMillis();
    while (!WL_Platform_ReadAUX()) {
        if ((WL_Platform_GetMillis() - start) >= timeout_ms) {
            WL_Platform_DebugPrint("[LoRa] wait AUX timeout\r\n");
            return false;
        }
        WL_Platform_DelayMs(1);
    }
    return true;
}

bool WL_LoRa_IsReady(void)
{
    return WL_Platform_ReadAUX();
}

/* ------------------------------------------------------------------ */
/*  AT command send/receive                                            */
/* ------------------------------------------------------------------ */

WL_LoRa_Status WL_LoRa_SendAT(const char *cmd,
                              char *resp_buf,
                              uint16_t resp_buf_len,
                              uint32_t timeout_ms)
{
    /* Flush the receive buffer to avoid stale data interference */
    WL_Platform_UART_FlushRx();

    /* Send AT command (EWM22A AT commands do not include CR/LF) */
    WL_Platform_UART_SendString(cmd);

    /* Wait and collect the response */
    char local_buf[RESP_BUF_SIZE];
    uint16_t pos = 0;
    uint32_t start = WL_Platform_GetMillis();

    memset(local_buf, 0, sizeof(local_buf));

    while ((WL_Platform_GetMillis() - start) < timeout_ms) {
        uint8_t byte;
        uint16_t n = WL_Platform_UART_Receive(&byte, 1);
        if (n > 0) {
            if (pos < (RESP_BUF_SIZE - 1U)) {
                local_buf[pos++] = (char)byte;
                local_buf[pos] = '\0';
            }

            /* Check if AT_OK has been received */
            if (strstr(local_buf, AT_OK_TOKEN) != NULL) {
                if (resp_buf != NULL && resp_buf_len > 0U) {
                    uint16_t copy_len = (pos < resp_buf_len) ? pos : (uint16_t)(resp_buf_len - 1U);
                    memcpy(resp_buf, local_buf, copy_len);
                    resp_buf[copy_len] = '\0';
                }

                char dbg[DBG_BUF_SIZE];
                snprintf(dbg, sizeof(dbg), "[LoRa] AT ok: %.48s\r\n", cmd);
                WL_Platform_DebugPrint(dbg);
                return WL_LORA_OK;
            }

            /* Check for error responses */
            if (strstr(local_buf, "AT_PARAM_ERROR") != NULL ||
                strstr(local_buf, "AT_ERROR") != NULL) {
                char dbg[DBG_BUF_SIZE];
                snprintf(dbg,
                         sizeof(dbg),
                         "[LoRa] AT fail: %.48s -> %.96s\r\n",
                         cmd,
                         local_buf);
                WL_Platform_DebugPrint(dbg);
                return WL_LORA_ERR_RESPONSE;
            }
        } else {
            WL_Platform_DelayMs(1);
        }
    }

    /* Timed out without a valid response */
    char dbg[DBG_BUF_SIZE];
    snprintf(dbg, sizeof(dbg), "[LoRa] AT timeout: %.48s\r\n", cmd);
    WL_Platform_DebugPrint(dbg);
    return WL_LORA_ERR_TIMEOUT;
}

/* ------------------------------------------------------------------ */
/*  Internal helper: send an AT command and check the result           */
/* ------------------------------------------------------------------ */

static WL_LoRa_Status _send_at_check(const char *cmd)
{
    return WL_LoRa_SendAT(cmd, NULL, 0, g_wl_config.at_response_timeout_ms);
}

/* ------------------------------------------------------------------ */
/*  Module initialization                                              */
/* ------------------------------------------------------------------ */

WL_LoRa_Status WL_LoRa_Init(void)
{
    WL_LoRa_Status st;
    char cmd[CMD_BUF_SIZE];

    WL_Platform_DebugPrint("[LoRa] init start\r\n");

    if (!g_wl_config.lora_run_at_init) {
        WL_Platform_DebugPrint("[LoRa] AT init skipped, transparent TX only\r\n");
        return WL_LORA_OK;
    }

    WL_Platform_ResetModule();
    WL_Platform_DelayMs(200U);

    /* 1. Wait for the module power-on self-test to complete (AUX goes high) */
    WL_Platform_DelayMs(g_wl_config.power_on_delay_ms);
    if (!WL_LoRa_WaitAUX(g_wl_config.at_response_timeout_ms)) {
        WL_Platform_DebugPrint("[LoRa] not ready\r\n");
        return WL_LORA_ERR_TIMEOUT;
    }

    /* 2. Enter configuration mode (mode 0) */
    st = _send_at_check("AT+HMODE=0");
    if (st != WL_LORA_OK) {
        return st;
    }
    WL_Platform_DelayMs(g_wl_config.mode_switch_delay_ms);
    if (!WL_LoRa_WaitAUX(g_wl_config.at_response_timeout_ms)) {
        return WL_LORA_ERR_TIMEOUT;
    }

    /* 3. Match the verified configuration command sequence */
    st = _send_at_check("ATE0");
    if (st != WL_LORA_OK) {
        return st;
    }

    snprintf(cmd, sizeof(cmd), "AT+RATE=%u", (unsigned)g_wl_config.lora_air_rate);
    st = _send_at_check(cmd);
    if (st != WL_LORA_OK) {
        return st;
    }

    snprintf(cmd, sizeof(cmd), "AT+PACKET=%u", (unsigned)g_wl_config.lora_packet_size);
    st = _send_at_check(cmd);
    if (st != WL_LORA_OK) {
        return st;
    }

    st = _send_at_check("AT+WOR=0");
    if (st != WL_LORA_OK) {
        return st;
    }

    snprintf(cmd, sizeof(cmd), "AT+POWER=%u", (unsigned)g_wl_config.lora_tx_power);
    st = _send_at_check(cmd);
    if (st != WL_LORA_OK) {
        return st;
    }

    snprintf(cmd, sizeof(cmd), "AT+TRANS=%u", (unsigned)g_wl_config.lora_trans_mode);
    st = _send_at_check(cmd);
    if (st != WL_LORA_OK) {
        return st;
    }

    snprintf(cmd, sizeof(cmd), "AT+ADDR=%u", (unsigned)g_wl_config.lora_addr);
    st = _send_at_check(cmd);
    if (st != WL_LORA_OK) {
        return st;
    }

    /* 5. Set channel */
    snprintf(cmd, sizeof(cmd), "AT+CHANNEL=%u", (unsigned)g_wl_config.lora_channel);
    st = _send_at_check(cmd);
    if (st != WL_LORA_OK) {
        return st;
    }

    /* 6. Set network ID */
    snprintf(cmd, sizeof(cmd), "AT+NETID=%u", (unsigned)g_wl_config.lora_net_id);
    st = _send_at_check(cmd);
    if (st != WL_LORA_OK) {
        return st;
    }

    snprintf(cmd, sizeof(cmd), "AT+KEY=%u", (unsigned)g_wl_config.lora_key);
    st = _send_at_check(cmd);
    if (st != WL_LORA_OK) {
        return st;
    }

    st = _send_at_check("AT+ERSSI=0");
    if (st != WL_LORA_OK) {
        return st;
    }

    st = _send_at_check("AT+DRSSI=0");
    if (st != WL_LORA_OK) {
        return st;
    }

    st = _send_at_check("AT+LBT=0");
    if (st != WL_LORA_OK) {
        return st;
    }

    st = _send_at_check("AT+ROUTER=0");
    if (st != WL_LORA_OK) {
        return st;
    }

    /* 11. Switch to UART/LoRa transparent mode (mode 1) */
    st = _send_at_check("AT+HMODE=1");
    if (st != WL_LORA_OK) {
        return st;
    }
    WL_Platform_DelayMs(g_wl_config.mode_switch_delay_ms);
    if (!WL_LoRa_WaitAUX(g_wl_config.at_response_timeout_ms)) {
        return WL_LORA_ERR_TIMEOUT;
    }

    WL_Platform_DebugPrint("[LoRa] init done\r\n");
    return WL_LORA_OK;
}

/* ------------------------------------------------------------------ */
/*  Data transmission                                                  */
/* ------------------------------------------------------------------ */

WL_LoRa_Status WL_LoRa_Send(const uint8_t *data, uint16_t len)
{
    if (data == NULL || len == 0U) {
        return WL_LORA_ERR_PARAM;
    }

    if (len > WL_TX_PAYLOAD_MAX) {
        WL_Platform_DebugPrint("[LoRa] payload too long\r\n");
        return WL_LORA_ERR_PARAM;
    }

    if (g_wl_config.lora_run_at_init && !WL_LoRa_WaitAUX(g_wl_config.at_response_timeout_ms)) {
        return WL_LORA_ERR_BUSY;
    }

    WL_LoRa_Status st = lora_send_payload(data, len);
    if (st != WL_LORA_OK) {
        return st;
    }

    char dbg[48];
    snprintf(dbg, sizeof(dbg), "[LoRa] TX %u bytes\r\n", (unsigned)len);
    WL_Platform_DebugPrint(dbg);

    return WL_LORA_OK;
}

WL_LoRa_Status WL_LoRa_SendString(const char *str)
{
    if (str == NULL) {
        return WL_LORA_ERR_PARAM;
    }

    return WL_LoRa_Send((const uint8_t *)str, (uint16_t)strlen(str));
}

void WL_LoRa_ServiceInit(void)
{
    memset(&s_service, 0, sizeof(s_service));
    s_service.ack_enabled = g_wl_config.ack_enable;
    s_service.link.last_error = WL_LORA_OK;
    service_sync_link_snapshot();
}

WL_LoRa_Status WL_LoRa_Enqueue(const uint8_t *data, uint16_t len)
{
    return service_push_queue(data, len);
}

WL_LoRa_Status WL_LoRa_EnqueueString(const char *str)
{
    if (str == NULL) {
        return WL_LORA_ERR_PARAM;
    }
    return WL_LoRa_Enqueue((const uint8_t *)str, (uint16_t)strlen(str));
}

void WL_LoRa_SetAckEnabled(bool enable)
{
    s_service.ack_enabled = enable;
    if (!enable && s_service.waiting_ack) {
        service_finish_success();
        return;
    }
    service_sync_link_snapshot();
}

const WL_LoRa_LinkStatus *WL_LoRa_GetLinkStatus(void)
{
    return &s_service.link;
}

void WL_LoRa_Tick(void)
{
    uint32_t now_ms = WL_Platform_GetMillis();

    service_poll_rx();

    if (!s_service.tx_active) {
        if (s_service.count == 0U) {
            service_sync_link_snapshot();
            return;
        }

        if (s_service.last_success_ms != 0U &&
            ((uint32_t)(now_ms - s_service.last_success_ms) < g_wl_config.tx_min_interval_ms)) {
            service_sync_link_snapshot();
            return;
        }

        if (s_service.last_tx_ms != 0U &&
            ((uint32_t)(now_ms - s_service.last_tx_ms) < g_wl_config.tx_min_interval_ms)) {
            service_sync_link_snapshot();
            return;
        }

        if (!service_pop_queue(&s_service.current)) {
            service_sync_link_snapshot();
            return;
        }

        s_service.tx_active = true;
        s_service.current_sent = false;
        s_service.waiting_ack = false;
        s_service.ack_received = false;
        s_service.retries_used = 0U;
        s_service.tx_start_ms = now_ms;
    }

    if (!s_service.current_sent) {
        if (g_wl_config.lora_run_at_init && !WL_Platform_ReadAUX()) {
            if ((uint32_t)(now_ms - s_service.tx_start_ms) >= g_wl_config.tx_timeout_ms) {
                (void)service_schedule_retry(now_ms, WL_LORA_ERR_BUSY);
            }
            service_sync_link_snapshot();
            return;
        }

        {
            WL_LoRa_Status st = lora_send_payload(s_service.current.payload, s_service.current.len);
            if (st != WL_LORA_OK) {
                service_finish_fail(st);
                return;
            }
        }
        s_service.last_tx_ms = now_ms;
        s_service.current_sent = true;
        s_service.tx_start_ms = now_ms;

        if (s_service.ack_enabled) {
            s_service.waiting_ack = true;
        } else {
            service_finish_success();
            return;
        }
    }

    if (s_service.waiting_ack) {
        if (s_service.ack_received) {
            service_finish_success();
            return;
        }

        if ((uint32_t)(now_ms - s_service.tx_start_ms) >= g_wl_config.ack_timeout_ms) {
            (void)service_schedule_retry(now_ms, WL_LORA_ERR_TIMEOUT);
            service_sync_link_snapshot();
            return;
        }
    }

    service_sync_link_snapshot();
}
