AndingDrLin/TDPS/TDPS/firmware/Inc/lf_app.h

/**
 * @file lf_app.h
 * @brief Line-following application state machine.
 *
 * State transitions:
 *   WAIT_START -> CALIBRATING -> RUNNING
 *   RUNNING <-> RECOVERING
 *   RUNNING -> AVOID_* -> RUNNING
 *   RUNNING -> FIXED_TURN_* -> RUNNING
 *   RUNNING -> REORIENT_* -> RUNNING
 */
#ifndef LF_APP_H
#define LF_APP_H

#include <stdbool.h>
#include <stdint.h>

#include "lf_config.h"
#include "lf_control.h"
#include "lf_radar.h"
#include "lf_sensor.h"

/** Application main state. */
typedef enum {
    LF_APP_STATE_BOOT = 0,
    LF_APP_STATE_WAIT_START,
    LF_APP_STATE_CALIBRATING,
    LF_APP_STATE_RUNNING,
    LF_APP_STATE_RECOVERING,
    LF_APP_STATE_AVOID_PREP,
    LF_APP_STATE_AVOID_BYPASS,
    LF_APP_STATE_AVOID_REACQUIRE,
    LF_APP_STATE_FIXED_TURN_STOP,
    LF_APP_STATE_FIXED_TURN_SPIN,
    LF_APP_STATE_FIXED_TURN_SETTLE,
    LF_APP_STATE_REORIENT_STOP,
    LF_APP_STATE_REORIENT_SPIN,
    LF_APP_STATE_REORIENT_CONFIRM,
    LF_APP_STATE_ULTRASONIC_HOLD,
    LF_APP_STATE_STOPPED,
    LF_APP_STATE_FAULT,
} LF_AppState;

/** Fixed-route phase for the competition course. */
typedef enum {
    LF_ROUTE_PHASE_WAIT_ARM = 0,       /**< After S-curve, first T-intersection -> right */
    LF_ROUTE_PHASE_T_RIGHT,            /**< Legacy: T-intersection -> right */
    LF_ROUTE_PHASE_LEFT_1,             /**< Left right-angle -> left */
    LF_ROUTE_PHASE_CROSS,              /**< Cross intersection x2 -> straight */
    LF_ROUTE_PHASE_LEFT_2,             /**< Left right-angle -> left */
    LF_ROUTE_PHASE_RIGHT_1,            /**< Right right-angle -> right */
    LF_ROUTE_PHASE_RIGHT_STRAIGHT,     /**< Right right-angle -> straight */
    LF_ROUTE_PHASE_RIGHT_2,            /**< Right right-angle -> right */
    LF_ROUTE_PHASE_T_LEFT,             /**< T-intersection -> left */
    LF_ROUTE_PHASE_LEFT_3,             /**< Left right-angle -> left */
    LF_ROUTE_PHASE_DONE,
} LF_RoutePhase;

/** Fixed-turn event type (for debug/telemetry observation). */
typedef enum {
    LF_ROUTE_EVENT_NONE = 0,
    LF_ROUTE_EVENT_FIRST_T_RIGHT,
    LF_ROUTE_EVENT_LEFT_RIGHT_ANGLE,
    LF_ROUTE_EVENT_RIGHT_RIGHT_ANGLE,
    LF_ROUTE_EVENT_T_LEFT,
} LF_RouteEvent;

/** Line-loss recovery phase. */
typedef enum {
    LF_RECOVER_FORWARD = 0,
    LF_RECOVER_BACKTRACK,
    LF_RECOVER_SWEEP_LEFT,
    LF_RECOVER_SWEEP_RIGHT,
    LF_RECOVER_CONFIRM,
} LF_RecoverPhase;

/**
 * @brief Application-layer context.
 *
 * Contains all runtime state for the line-following state machine.
 * Keil Watch can observe this struct directly for debugging.
 */
typedef struct {
    /* Basic state */
    LF_AppState state;
    uint32_t boot_ms;
    uint32_t last_step_us;
    uint32_t wait_start_line_since_ms;
    uint32_t calib_start_ms;
    uint32_t run_start_ms;
    bool calibration_ok;
    bool calibration_degraded;
    bool run_finalized;

    /* Line-following control */
    LF_PIDState pid;
    LF_SensorFrame last_frame;
    int16_t current_target_speed;
    int8_t last_seen_dir;
    int8_t trusted_line_dir;
    int32_t last_trusted_position;
    bool trusted_line_valid;
    uint8_t line_lost_count;

    /* Radar snapshot */
    LF_RadarObstacleState obstacle_state;
    uint16_t obstacle_distance_mm;
    bool radar_has_target;
    bool radar_frame_valid;
    uint32_t radar_frame_count;
    uint32_t radar_last_update_ms;
    uint32_t radar_frame_age_ms;

    /* Line-loss recovery */
    uint32_t recover_start_ms;
    uint32_t recover_phase_start_ms;
    uint8_t recover_phase;
    uint8_t recover_confirm_count;
    uint16_t recovery_count;

    /* Obstacle avoidance */
    int8_t avoid_dir;
    uint32_t avoid_state_start_ms;
    uint8_t avoid_confirm_count;

    /* Fixed 90-degree turn */
    uint32_t fixed_turn_phase_start_ms;
    int8_t fixed_turn_dir;
    uint8_t fixed_turn_event;
    uint32_t route_last_event_ms;

    /* Right-angle reorientation spin */
    int8_t reorient_spin_dir;
    uint32_t reorient_start_ms;
    uint32_t reorient_last_finish_ms;
    uint8_t reorient_confirm_count;

    /* Fixed-route script */
    uint8_t route_phase;
    uint8_t route_cross_count;
    uint8_t route_event_confirm_count;
    bool route_cross_armed;

    /* Segment control */
    LF_SegmentType segment_type;
    LF_SegmentType segment_candidate;
    uint8_t segment_candidate_count;
    uint8_t segment_hold_count;
    int8_t position_sign_history[20];
    uint8_t sign_history_index;
    uint8_t direction_switch_count;

    /* Ultrasonic overhead obstacle hold */
    uint32_t ultrasonic_hold_start_ms;
    bool ultrasonic_lora_sent;
    uint32_t ultrasonic_cooldown_until_ms;
} LF_AppContext;

void LF_App_Init(void);
void LF_App_RunStep(void);
void LF_App_NotifyCheckpoint(uint32_t checkpoint_id);
const LF_AppContext *LF_App_GetContext(void);

#endif /* LF_APP_H */
