AndingDrLin/TDPS/TDPS/firmware/Src/wl_config.c

/**
 * @file    wl_config.c
 * @brief   Default runtime configuration for the wireless module.
 */

#include "wl_config.h"

const WL_Config g_wl_config = {
    /* Team information */
    .team_number            = WL_TEAM_NUMBER,
    .team_name              = WL_TEAM_NAME,

    /* LoRa parameters */
    .lora_addr              = WL_LORA_ADDR,
    .lora_channel           = WL_LORA_CHANNEL,
    .lora_net_id            = WL_LORA_NET_ID,
    .lora_air_rate          = WL_LORA_AIR_RATE,
    .lora_tx_power          = WL_LORA_TX_POWER,
    .lora_trans_mode        = WL_LORA_TRANS_MODE,
    .lora_packet_size       = WL_LORA_PACKET_SIZE,
    .lora_key               = WL_LORA_KEY,
    .lora_fixed_dest_addr   = WL_LORA_FIXED_DEST_ADDR,
    .lora_fixed_dest_channel = WL_LORA_FIXED_DEST_CHANNEL,

    /* UART parameters */
    .uart_baudrate          = WL_UART_BAUDRATE,

    /* Timeout parameters */
    .at_response_timeout_ms = WL_AT_RESPONSE_TIMEOUT_MS,
    .mode_switch_delay_ms   = WL_MODE_SWITCH_DELAY_MS,
    .power_on_delay_ms      = WL_POWER_ON_DELAY_MS,
    .tx_min_interval_ms     = WL_TX_MIN_INTERVAL_MS,
    .tx_timeout_ms          = WL_TX_TIMEOUT_MS,
    .ack_timeout_ms         = WL_ACK_TIMEOUT_MS,
    .tx_retry_max           = WL_TX_RETRY_MAX,
    .ack_enable             = WL_ACK_ENABLE,
    .lora_run_at_init       = WL_LORA_RUN_AT_INIT,
    .status_report_period_ms = WL_STATUS_REPORT_PERIOD_MS,
    .timed_checkpoint_delay_ms = WL_TIMED_CHECKPOINT_DELAY_MS,

    /* Checkpoints */
    .checkpoint_arch_2_1    = WL_CHECKPOINT_ARCH_2_1,
    .checkpoint_arch_2_2    = WL_CHECKPOINT_ARCH_2_2,
    .timed_checkpoint_id    = WL_TIMED_CHECKPOINT_ID,

    /* Queue parameters */
    .tx_queue_size          = WL_TX_QUEUE_SIZE,
};
