AndingDrLin/TDPS/TDPS/firmware/Src/wl_protocol.c

/**
 * @file    wl_protocol.c
 * @brief   Wireless communication data protocol layer -- arch message packing.
 */

#include "wl_protocol.h"
#include "wl_config.h"

#include <stdio.h>
#include <string.h>

/* ------------------------------------------------------------------ */
/*  Message construction                                               */
/* ------------------------------------------------------------------ */

uint16_t WL_Protocol_BuildCheckpointMsg(char *buf,
                                         uint16_t buf_len,
                                         uint32_t checkpoint_id,
                                         uint32_t elapsed_ms)
{
    if (buf == NULL || buf_len == 0) {
        return 0;
    }

    uint32_t total_seconds = elapsed_ms / 1000U;
    uint32_t minutes = total_seconds / 60U;
    uint32_t seconds = total_seconds % 60U;

    int n = snprintf(buf, buf_len,
                     "TEAM=%u,NAME=%s,CP=%u,TIME=%02u:%02u\n",
                     (unsigned)g_wl_config.team_number,
                     g_wl_config.team_name,
                     (unsigned)checkpoint_id,
                     (unsigned)minutes,
                     (unsigned)seconds);

    if (n < 0 || (uint16_t)n >= buf_len) {
        buf[0] = '\0';
        return 0U;
    }

    return (uint16_t)n;
}

uint16_t WL_Protocol_BuildCustomMsg(char *buf,
                                     uint16_t buf_len,
                                     const char *text)
{
    if (buf == NULL || buf_len == 0 || text == NULL) {
        return 0;
    }

    int n = snprintf(buf, buf_len,
                     "TEAM=%u,NAME=%s,MSG=%s\n",
                     (unsigned)g_wl_config.team_number,
                     g_wl_config.team_name,
                     text);

    if (n < 0 || (uint16_t)n >= buf_len) {
        buf[0] = '\0';
        return 0U;
    }

    return (uint16_t)n;
}
