AndingDrLin/TDPS/TDPS/tests/standalone/line_sensor_uart_8plus2_test/Core/Inc/lf_control.h

#ifndef LF_CONTROL_H
#define LF_CONTROL_H

#include <stdint.h>

typedef struct {
    float integral;
    float prev_error;
    float filtered_derivative;
    float prev_output;
    uint8_t initialized;
} LF_PIDState;

/* PID 状态初始化。 */
void LF_Control_ResetPid(LF_PIDState *pid);

/* 基于当前偏差计算修正量。输出单位与电机命令一致（-1000~1000）。 */
int16_t LF_Control_UpdatePid(float error, float dt_s, LF_PIDState *pid);

/* 将基础速度和修正量合成为左右轮命令。 */
void LF_Control_ComputeMotorCmd(int16_t base_speed, int16_t correction, int16_t *out_left, int16_t *out_right);

#endif /* LF_CONTROL_H */
