AndingDrLin/TDPS/TDPS/simulator/sim_tests/common/harness/lf_harness_scenarios.c

#include "lf_harness_scenarios.h"

#include <ctype.h>
#include <errno.h>
#include <stdio.h>
#include <stdlib.h>
#include <string.h>

#define LFH_SCENARIO_MAX 48U
#define LFH_ID_MAX 64U
#define LFH_NAME_MAX 96U
#define LFH_LINE_MAX 768U
#define LFH_BASE_FIELD_COUNT 12U
#define LFH_EXT_FIELD_COUNT 21U

static LFH_Scenario g_scenarios[LFH_SCENARIO_MAX];
static char g_ids[LFH_SCENARIO_MAX][LFH_ID_MAX];
static char g_names[LFH_SCENARIO_MAX][LFH_NAME_MAX];
static size_t g_entry_count = 0U;
static const char *k_default_config_path = "TDPS/simulator/sim_tests/line_follow_v1/config/scenarios_default.csv";

static char *lfh_trim(char *text)
{
    char *start = text;
    char *end;

    while ((*start == '\0') == false && isspace((unsigned char)(*start)) > 0) {
        start += 1;
    }

    end = start + strlen(start);
    while (end > start) {
        const unsigned char ch = (unsigned char)end[-1];
        if (isspace(ch) == 0) {
            break;
        }
        end -= 1;
        *end = '\0';
    }

    return start;
}

static size_t lfh_split_csv(char *line, char *fields[LFH_EXT_FIELD_COUNT])
{
    size_t count = 0U;
    char *cursor = line;

    while (count < LFH_EXT_FIELD_COUNT) {
        fields[count] = cursor;
        count += 1U;

        {
            char *comma = strchr(cursor, ',');
            if (comma == NULL) {
                break;
            }
            *comma = '\0';
            cursor = comma + 1;
        }
    }

    return count;
}

static bool lfh_parse_double_range(const char *text, double min_v, double max_v, double *out)
{
    char *end = NULL;
    double value;

    errno = 0;
    value = strtod(text, &end);
    if (errno == 0 && (end == text) == false && *end == '\0') {
        if (value >= min_v && value <= max_v) {
            *out = value;
            return true;
        }
    }

    return false;
}

static bool lfh_parse_u32(const char *text, uint32_t *out)
{
    char *end = NULL;
    unsigned long value;

    errno = 0;
    value = strtoul(text, &end, 10);
    if (errno == 0 && (end == text) == false && *end == '\0' && value <= 0xffffffffUL) {
        *out = (uint32_t)value;
        return true;
    }

    return false;
}

static bool lfh_parse_bool(const char *text, bool *out)
{
    if (strcmp(text, "true") == 0 || strcmp(text, "1") == 0 || strcmp(text, "yes") == 0) {
        *out = true;
        return true;
    }
    if (strcmp(text, "false") == 0 || strcmp(text, "0") == 0 || strcmp(text, "no") == 0) {
        *out = false;
        return true;
    }
    return false;
}

static bool lfh_parse_obstacle_mode(const char *text, LFH_ObstacleMode *mode)
{
    if (strcmp(text, "none") == 0) {
        *mode = LFH_OBSTACLE_NONE;
        return true;
    }
    if (strcmp(text, "fixed") == 0) {
        *mode = LFH_OBSTACLE_FIXED;
        return true;
    }
    if (strcmp(text, "random") == 0) {
        *mode = LFH_OBSTACLE_RANDOM;
        return true;
    }
    return false;
}

const char *LFH_Scenarios_TrackName(LFH_TrackType track)
{
    if (track == LFH_TRACK_CIRCLE) {
        return "circle";
    }
    if (track == LFH_TRACK_FIGURE8) {
        return "figure8";
    }
    if (track == LFH_TRACK_PATIO_REAL) {
        return "patio_real";
    }
    return "patio_proxy";
}
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
