AndingDrLin/TDPS/(commit log)

2026-03-09 添加了地图的俯视图，新增了docs文件夹
2026-03-10 更新 README.md，添加参考开源项目列表；新增巡线子系统技术报告文档
2026-03-10 修改了文件夹命名
2026-03-10 完成了巡线部分 v1的代码实现
2026-03-10 更新 README.md 中的文件路径，修正代码引用；修改 lf_app.c 中的注释逻辑以提高代码可读性；修复了丢线后先朝反方向转的问题
    [lf_app.c]
2026-03-19 新增自动化回归测试脚本和稳定性测试脚本；更新 README.md，添加测试说明和输出文件信息
2026-03-19 更新子项目 TDPS-Simulator 的提交引用
2026-03-20 重构巡线文档和测试脚本
2026-03-27 feat: add wireless_v1 module (Task 2 - LoRa communication)
2026-03-27 fix: integrate task2 wireless checkpoints and add autotests
    [lf_app.c, lf_app.h, main.c, wireless_hooks.c, wireless_hooks.h, wl_app.c, wl_config.h, wl_lora.c]
2026-04-15 feat: Implement radar integration and asynchronous LoRa communication
    - Updated LF_Config to include radar parameters and sensor weights.
    - Added LF_Platform_RadarRead function for radar data handling.
    - Introduced LF_Radar module for radar frame parsing and obstacle state management.
    - Enhanced LF_Sensor_ReadFrame to calculate peak value and edge hint.
    - Expanded WL_Config for asynchronous LoRa communication settings.
    - Implemented WL_LoRa asynchronous sending with retry and optional ACK.
    - Updated WL_App to handle periodic status reporting and integrate with LoRa.
    - Enhanced wireless communication documentation to reflect new features.
    - Added tests for radar and wireless functionalities.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
2026-04-16 feat: 添加对8路巡线传感器的输入模式支持，包括 GPIO、UART 和 I2C 接口
2026-05-13 refactor: 统一 STM32F407VET6 固件工程结构
    将巡线、雷达和无线模块收敛到 firmware 目录，并加入 F407 单 MCU 平台端口、共享工具和 PC stub 构建入口，降低后续上板与回归维护成本。
2026-05-13 fix: 修复 TDPS-Simulator 子模块引用
    更新子模块指针到可用的 main 分支提交，并包含仿真器对统一 firmware 目录和 8 路巡线传感器的适配。
2026-05-13 docs: 更新统一固件工程说明和测试命令
    同步 README、测试说明和忽略规则到新的 firmware 目录结构，避免继续引用已移除的旧模块路径和不存在的仿真脚本。
2026-05-15 feat: 实现雷达避障状态机和调试监控
2026-05-15 test: 补充巡线避障和无线队列回归测试
2026-05-15 docs: 更新巡线避障调参和仿真验证说明
2026-05-15 chore: 更新构建产物和系统文件忽略规则
2026-05-15 chore: 更新巡线仿真子模块引用
2026-05-15 chore: 忽略本地文档
2026-05-15 feat: 增强巡线调试和鲁棒性
2026-05-17 fix: align wireless payload with task format
    Use the assignment-required MM:SS race duration in checkpoint payloads and add a host serial payload sender for validating the firmware communication path without MCU power.
    [test_wl_stub.c, wl_app.c, wl_pc_serial_main.c, wl_platform_posix_serial.c, wl_platform_stub.c, wl_port_posix_serial.h, wl_protocol.c, wl_protocol.h]
2026-05-17 feat: 添加LoRa模块复位功能并更新 LoRa 初始化逻辑
2026-05-20 feat: 添加岔路检测和决策逻辑，增强巡线功能
2026-05-20 fix: 修正雷达UART波特率和确认帧数以提高稳定性
2026-05-26 feat: 添加DGUS屏幕驱动并改进雷达稳定性，清理gitignore
    - 添加 lf_dgus_screen 模块用于DGUS串口屏通信
    - 改进雷达UART配置和确认逻辑以提高稳定性
    - 从git跟踪中移除slides/等二进制文件
    - 更新.gitignore忽略PDF、图片、IDE项目等非代码文件
2026-05-26 init: 项目顶层仓库，添加参考代码和文档生成脚本
    - 添加 .gitignore 排除 PDF、Office 文档、二进制文件等
    - 添加 radar_test_ref 参考代码（雷达测试）
    - 添加 notebook/scripts 笔记本文档生成脚本
    - 添加 mid_reports/scripts 报告生成脚本
    - 固件主代码和仿真器分别在 TDPS/ 和 TDPS-Simulator/ 子仓库管理
2026-05-26 chore: 补充.gitignore忽略docs/、生成产物和更多二进制格式
2026-05-28 chore: restructure project layout for vehicle development
    Organize firmware, simulator, tests, reports, and agent-facing project context under TDPS so future full-vehicle work has a single readable project root.
    [scenarios_default.csv, scenarios_full_course.csv, scenarios_task.csv]
2026-05-28 fix: 更新STM32F4xx_DFP包版本和相关配置
2026-05-28 fix: 修复Keil Rebuild编译错误并补齐STM32板级初始化
    修复 TDPS_LineFollow 工程中的编译错误：补齐 HAL 类型依赖、处理未定义屏幕句柄、
    补入缺失的外设句柄定义与 PWM 时钟初始化，并同步 Keil/CMake 工程引用。
    [lf_board_stm32f4.c, lf_platform_stm32f4_hal.c, lf_sensor_uart.h]
2026-05-29 fix: update firmware LoRa fixed-mode configuration
    Configure the EWM22A module at startup with the requested address, channel, network ID, packet size, fixed mode, and no LoRa key while routing the firmware port to the current UART5 PCB pins.
    [wl_config.c, wl_config.h, wl_lora.c, wl_lora.h, wl_platform_stm32f4.c, wl_port_stm32f4.h]
2026-05-29 feat: add standalone LoRa module test project
    Add a minimal STM32F407 Keil project for validating the EWM22A LoRa module over UART5 with AT configuration, fixed-mode broadcast test frames, and Keil Watch controls.
    [main.c, main.h]
2026-05-29 fix: update standalone LoRa test payload
    Send the requested standalone LoRa test message and expose the last payload in the Watch state for verification.
    [main.c, main.h]
2026-05-29 fix: enable DMA HAL for LoRa module test
    Ensure the standalone LoRa Keil target exposes UART DMA handle types and compiles the DMA HAL sources.
2026-05-29 fix: expose radar standalone debug state
    Expose LD2410S runtime counters and a volatile watch struct so the standalone radar test can be inspected through Keil/STLink on the assembled vehicle.
    [ld2410s.c, ld2410s.h, main.c]
2026-05-29 fix: tune firmware line-follow recovery
    Tighten line detection with peak and contrast checks, adjust speed tuning, and hold the last known line direction briefly before entering recovery.
    [lf_app.c, lf_app.h, lf_config.c, lf_config.h, lf_sensor.c, lf_sensor.h]
2026-05-29 fix: enable standalone LoRa auto send
    Enable the module test to transmit periodically after configuration succeeds and expose received payloads in the watch state for board-to-board checks.
    [main.c, main.h]
2026-05-29 fix: make radar standalone Keil project self-contained
    Bundle the required Core, MDK-ARM, HAL, and CMSIS files so the radar test can be opened and built directly without depending on outer firmware paths.
    [ld2410s.c, ld2410s.h, main.c, main.h]
2026-05-29 fix: change the communication address and update README for LoRa module.
    [main.c, main.h]
2026-05-29 fix: remove radar standalone LED dependency
    Make the radar standalone test rely only on Keil Watch state so it remains usable on boards without the old LED outputs.
    [main.c, main.h]
2026-05-30 test: add UART line sensor standalone project
    Add a self-contained Keil 5 standalone project for testing the 8-channel UART line sensor and auxiliary GPIO sensors through STLink Watch, and align firmware UART parsing with the documented ASCII protocol.
2026-05-30 fix: gate line-follow start on stable line detection
    [lf_app.c, lf_app.h, lf_config.c, lf_config.h, lf_config_profiles.c, main.c, test_lf_stub.c]
2026-05-30 fix: align wireless timing with race start
    [test_wl_stub.c, wl_app.c, wl_config.c, wl_config.h]
2026-05-30 fix: restore Keil firmware build
    [lf_board_stm32f4.c, lf_platform_stm32f4_hal.c]
2026-05-30 fix: enable motor output for road test
    Ensure the road-test Keil build does not swallow motor commands and apply the line-follow test profile before board peripherals are initialized.
    [main.c]
2026-05-30 fix: correct motor pin mapping
    Map the motor outputs to the board wiring and invert motor A's forward level so positive commands drive both wheels forward.
    [board_pins.h, lf_board_stm32f4.c, lf_port_stm32f4_hal.h]
2026-05-30 fix: align line sensor board setup
    Match the main firmware line sensor UART and auxiliary GPIO setup to the standalone test so UART mode does not reconfigure ADC pins.
    [lf_board_stm32f4.c, lf_port_stm32f4_hal.h]
2026-05-30 chore: improve line debug visibility
    Shorten debug-mode line hold time and include raw line and contrast telemetry for faster board bring-up.
    [lf_config_profiles.c, lf_debug_monitor.c]
2026-05-30 fix: update LoRa initialization and debug mode configuration
    [lf_debug_monitor.c, wl_config.h]
2026-05-30 feat: implement LF_WatchDebug functions for application and motor updates
2026-05-30 feat: update LF_Config_ApplyDebugProfile and LF_Platform_ReadLineSensorRaw for improved sensor command handling
2026-05-30 feat: enhance LF_WatchDebug structure with additional raw and norm sensor data fields
2026-05-30 feat: update LF_Config_ApplyDebugProfile for improved sensor configuration and performance
2026-05-30 feat: update LF_Config_ApplyDebugProfile to enable sensor polarity inversion and enhance debug output
2026-05-30 feat: add sensor weights configuration in LF_Config_ApplyDebugProfile for enhanced sensor handling
2026-05-30 feat: update LF_Config_ApplyDebugProfile and lf_port_stm32f4_hal.h for improved control parameters and motor direction handling
2026-05-30 feat: update LF_PORT_LEFT_FORWARD_LEVEL and LF_PORT_RIGHT_FORWARD_LEVEL for correct motor direction handling
    [lf_port_stm32f4_hal.h]
2026-05-30 feat: fix motor command calculation for correct direction handling
    [lf_control.c]
2026-05-30 feat: add track profile for faster stable line following
    Enable the default track profile so the car can test higher straight-line speed, predictive curve slowdown, interference filtering, U-turn recovery, and fork detection together.
    [lf_app.c, lf_app.h, lf_config.c, lf_config.h, lf_config_profiles.c, main.c]
2026-05-30 docs: update line following track profile guidance
    Document the new track profile defaults, tuning workflow, quick simulation result, and current startup behavior so future testing matches the firmware state.
2026-05-31 feat: add OptimalProfile with balanced PID for straight+U-turn+straight track
    新增 LF_Config_ApplyOptimalProfile() 巡线配置预设，综合 debug 稳定性与 competition 速度优势:
    - 适中 PID (kp=0.20, kd=0.65) 避免过激修正和蛇形摆动
    - 零电机死区 (motor_deadband=0) 消除响应滞后导致的突然大动作
    - 自适应降速: 直道 base_speed=260, 弯道自动降至 sharp_turn_speed=160
    - 提前弯道检测 (adaptive_error_threshold=600) 确保入弯前充分减速
    - 有效丢线恢复 (recover_backtrack+sweep)，替代 debug 禁用的恢复机制
    - 输出平滑 (max_output_delta_per_tick=35) 避免修正量剧烈跳变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
    [lf_app.c, lf_app.h, lf_config.c, lf_config.h, lf_config_profiles.c, lf_control.c, lf_port_stm32f4_hal.h]
2026-05-31 fix: restore conservative debug line-follow profile
    Default to the low-speed debug profile and remove the track profile path so real-car testing starts from the stable baseline unless competition mode is explicitly selected.
    [lf_app.c, lf_config.c, lf_config.h, lf_config_profiles.c, main.c]
2026-05-31 feat: 更新调试配置文件以优化基本速度和修正参数
2026-05-31 fix: 调整调试配置文件中的PID参数和速度设置以优化性能
2026-05-31 fix: 将直线稳定性调整到较好状态，U型弯可以走到顶点，但是无法回头
2026-05-31 fix: 增加长前探巡线路口补偿
    通过前探补偿和直线噪声抑制，让长车身在路口与 U 型弯中先对齐驱动轮轴线再转向，减少过早转向和直线误减速。
    [lf_app.c, lf_app.h, lf_config.c, lf_config.h, lf_config_profiles.c, test_lf_stub.c]
2026-05-31 doc: 更新巡线和调试文档，修正参数和补偿说明以优化性能
2026-05-31 fix: 调整引导事件阈值和配置，优化巡线性能
2026-05-31 fix: 调整调试配置文件中的最大修正量和曲线准备启用状态以优化性能
2026-05-31 fix: 调整PID参数达到直线巡线baseline
2026-05-31 fix: 增加传感器边缘噪声抑制功能及相关参数，优化巡线性能
2026-05-31 fix: 调整控制参数以优化巡线性能，减少误差死区和软区
2026-05-31 fix: 启用前探补偿并调整相关参数以优化特殊线型检测性能
2026-05-31 fix: 调整了P环参数和速度
2026-05-31 fix: 调整巡线参数，但不能保证直线和弯道同时稳定
2026-05-31 fix: 略微增强巡线的稳定性与弯道表现
2026-05-31 feat: 新增Kp随速度缩放功能，并调整了基础Kp值
2026-05-31 fix: 调整入弯减速触发阈值，使得减速时机提前
2026-05-31 feat: 全面重构PID控制算法与实时性架构，并添加专业中文注释
    - PID积分分离+变速积分：大误差区指数衰减，过渡区线性降速，小误差区全速积分
    - 3样本中值滤波：消除传感器脉冲噪声，冷启动安全保护
    - FSM显式优先级仲裁：LINE_LOST > FORK > OBSTACLE > LEAD > PID_CONTROL
    - DWT微秒级时间戳：dt_s精度从1ms提升至1μs
    - UART非阻塞发送：传感器命令改为中断发送模式
    - NVIC优先级阶梯：TIM(3) > 传感器(4) > 雷达(5) > TX Complete(6)
    - 主循环纯事件分发器：移除DelayMs(1U)阻塞
    - 全部巡线固件文件添加面向人类程序员的专业中文注释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
2026-06-01 fix: 修复模拟器几何参数与路径引用错误
    - 传感器前距从16cm修正为22cm（与实车一致）
    - 轮距从20cm修正为16cm（与实车一致）
    - 新增LF_Platform_GetMicros桩函数
    - 修复6个脚本中ROOT_DIR路径引用（TDPS-Simulator→TDPS/simulator）
    [lf_harness_cli.c, lf_harness_core.c, lf_harness_scenarios.c]
2026-06-01 feat: 实现6参数简化PD+kff控制架构，替代62参数系统
    - 新增min_speed/kff配置字段，支持曲率前馈
    - 新增LF_Control_UpdatePD纯PD函数（无积分/死区/软区/变化率限幅）
    - process_running新增TDPS_SIMPLE_CONTROL分支：连续速度函数+PD+kff差速合成
    - 将两轮参数扫描最佳值写入lf_config.c和Debug Profile（kp=0.25/kd=1.20/kff=0.0008/base=280）
    - 关闭straight_boost/curve_prepare/积分/死区等简化模式下无效功能
    - 模拟器新增TDPS_SIM_MIN_SPEED/TDPS_SIM_KFF宏，修复base_speed硬编码bug
    - 参数扫描脚本新增min_speed/kff维度支持
    [lf_app.c, lf_config.c, lf_config.h, lf_config_profiles.c, lf_control.c, lf_control.h, run_line_follow_param_sweep.py]
2026-06-01 feat: 新增参数扫描粗扫赛道配置（圆形+八字双场景）
    [scenarios_sweep_coarse.csv]
2026-06-01 docs: 更新巡线文档与项目记忆以反映6参数简化PD+kff架构
    - tuning.md: 新增架构说明、kff/min_speed文档、参数扫描结果、更新所有参数表
    - line_following.md: 控制器描述从PID更新为PD+kff，补充核心公式
    - agent_docs: 记录重构里程碑、更新风险项和下一步建议
    - CLAUDE.md: 新增巡线控制架构说明
2026-06-01 fix: 调整PD参数防止直线震荡，暂时关闭kff
2026-06-01 fix: 减小kd阻尼尝试消除直线抖动
2026-06-01 feat: 增加微分滤波和变化率限制，防止直线抖动
2026-06-01 feat: 增加死区保护以吸收传感器噪声，调整控制参数以优化直线行驶
2026-06-01 feat: 打开kff，开始调试；缩短弯道修正响应时间
2026-06-01 feat: 调整控制参数以优化死区响应，增加软区平滑处理
2026-06-01 fix: 解决入弯太快、弯中摆头、箭头岔路走错
2026-06-01 feat: 打开前探功能并防止在箭头处触发
2026-06-01 fix: 修复前探功能在直线上误触发导致上线即转向
    frame_is_lead_event() 居中检测逻辑将 || 误写为 &&，导致直线上
    edge_hint=0 恒真，每帧都触发 lead event。改为 && 要求同时满足
    "无边缘"且"最近从侧面进入过"，直线上 entry_memory_count=0 不再误触发。
    同时抬高 lead_event_min_sum 至 4000，提供双层保护。
    [lf_app.c, test_lf_stub.c]
2026-06-02 feat: 反转电机指令以适配倒装结构
2026-06-02 feat: 调整调试和比赛配置参数以优化倒三轮性能
2026-06-03 docs: 添加最终报告 IEEE LaTeX 源码和 10 个矢量图生成脚本
2026-06-03 docs: 更新 PCB 工程文件引用
2026-06-03 chore: 忽略最终报告中间产物和模板参考文件
2026-06-03 feat: 简化调试配置参数以优化倒三轮性能
2026-06-03 fix: 调整巡线参数，目前可以直线巡线
2026-06-03 仍然直线还不能转
2026-06-03 fix: 更新工具链版本和配置参数以支持新特性
2026-06-03 fix: 删除了重复的参数
2026-06-03 fix: 调整了一些参数，直线会走一下猛打方向，右弯进弯会向左转
2026-06-03 fix: 关闭了新增的冗余功能
2026-06-03 feat: 加入进弯判断逻辑和配套参数；加入弯道专用状态
2026-06-03 feat: 重构弯道处理逻辑，删除探测机制，优化 PID 状态管理
2026-06-03 feat: 在曲线中使用PID控制，出弯时恢复max_delta控制。
2026-06-03 feat: 当前版本可以通过U型弯
2026-06-03 feat: 更新 CLAUDE.md 文件，增加 CMake 选项和控制架构说明
2026-06-03 feat: 优化 PID 控制参数，增强连续S弯跟踪能力
2026-06-03 feat: 添加原地旋转对准功能，增强急弯处理能力
2026-06-03 feat: 添加急弯检测与原地旋转对准功能，增强丢线处理能力
2026-06-04 feat: 添加直角转弯检测功能，优化急弯原地旋转策略，调整相关配置参数
2026-06-04 feat: 添加分段控制系统，增强连续弯和直角转弯处理能力
    新增功能：
    - 路段检测(LF_SegmentType)：直道/缓弯/急弯/宽线路口/岔路/丢线6种类型
    - 分段参数：每种路段独立kp/kd/kff/base_speed/min_speed/max_correction
    - 连续弯增强：方向切换检测，扩展丢线宽容期(+4帧)，最后急转向尝试
    - 直角转弯增强：放宽检测条件(active>=4)，新增REORIENT_APPROACH靠近弯点，旋转超时后倒车重试
    - T字/十字路口检测：大面积亮且无方向暗角亦触发reorient停车旋转
    - 调试输出增加：seg=<类型> seg_sw=<方向切换计数> retry=<重试次数>
    - 路段切换滞后机制：3帧确认+8帧保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
2026-06-04 fix: 修复了编译bug
2026-06-04 fix: 修复原地转向判断问题导致车只能前后挪动的问题，目前可以较好地到达连续弯后的直角转弯
2026-06-04 feat: 添加原地旋转冷却机制和停车等待时间，优化急弯处理逻辑
2026-06-04 feat: 将直角弯的判断改为传感器通道条件，调整弯道参数以提高响应速度和转向力度
2026-06-04 fix: 优化巡线稳定性，有概率通过直角弯
2026-06-04 fix: 调整参数增强直线稳定性、过弯灵敏度和转向力度
2026-06-04 fix: 调整了直角弯的判断逻辑；减少了S弯判断的等待帧数；修改参数增强弯道跟线能力
2026-06-04 feat: 添加配置文件和特征文件到无线自动测试和巡线自动测试的编译列表
2026-06-04 docs: 更新文档适配最新代码
2026-06-04 docs: 更新CLAUDE.md
2026-06-05 docs: 更新CLAUDE.md，移除回答开头的固定语句
2026-06-05 fix 优化段落检测和曲线方向历史更新逻辑；调整配置文件以增强急弯转向能力
2026-06-05 fix 优化直角转弯即时判定和箭头干扰保护
    当前状态：直角转弯和箭头干扰仍然不稳定，需继续实车调试。
2026-06-05 feat 固定路线脚本配置：新增 route_script_enable/confirm/cooldown 字段，fixed_turn 时间从420ms→720ms
    [lf_config.c, lf_config.h, lf_config_profiles.c]
2026-06-05 feat 固定路线硬脚本：D帧数字值检测直角/T口/十字，优先级提前于丢线恢复，RECOVERING中也检测硬事件
    - 直角检测只看 D帧：通道8灭+1~6亮=左直角，或通道1灭+3~8亮=左直角
    - 全亮检测只看 D帧：8路全0
    - 路线阶段机写死：初始→等T口右转→等左直角→数两个十字→等最后左直角
    - D帧极性修正：0=黑线=亮，1=白底=灭（之前反了）
    - fixed_turn_90_ms 从420→720ms，spin_speed 从180→200
    [lf_app.c]
2026-06-05 feat 增加固定转弯状态、路线阶段枚举和上下文字段到 lf_app.h
2026-06-05 docs 同步固定路线脚本文档：D帧极性、硬事件检测、已知原地旋转问题
2026-06-05 test 补充固定路线硬脚本 stub 测试：T口右转、十字计数、D帧极性修正
    [test_lf_stub.c]
2026-06-05 fix: 仍然无法通过直角和T型路口
2026-06-06 refactor 精简巡线核心：保留固定路线脚本和固定转弯
2026-06-06 chore 清理未使用DGUS和运行日志模块，同步Keil工程
2026-06-06 chore 清理旧雷达屏幕实验归档
2026-06-08 refactor: restructure project for open-source layout
    - Move docs/, docs_reference/, reports/ to repository root
    - Delete agent_docs/ (AI context files)
    - Merge TDPS/.gitignore, TDPS/CLAUDE.md, TDPS/README.md into root
    - Update all path references in CLAUDE.md, .gitignore, report READMEs
    - Add docs/hardware.md with pin mapping migrated from agent_docs
    - Add LICENSE (Apache 2.0)
2026-06-08 refactor: split lf_app.c into focused modules, add ultrasonic sensor, translate all comments
    Firmware modularization:
    - Split lf_app.c (1275 lines) into 6 focused modules:
    lf_app_util (state transitions), lf_app_sensor (lane queries),
    lf_app_route (route script), lf_app_segment (segment detection),
    lf_app_avoid (avoidance/turns/reorient), lf_app (orchestrator)
    - Add lf_app_internal.h for shared state between modules
    Ultrasonic overhead obstacle detection:
    - Add lf_ultrasonic.c driver with non-blocking state machine
    - Add STM32F4 HAL and PC stub platform implementations
    - Add ULTRASONIC_HOLD state: stop -> LoRa -> wait -> resume
    - Add 6 config fields (enable, threshold, hold_ms, checkp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
    [lf_app.c, lf_app.h, lf_app_avoid.c, lf_app_avoid.h, lf_app_internal.h, lf_app_route.c, lf_app_route.h, lf_app_segment.c]
2026-06-08 refactor: polish all firmware comments to professional English
    - Add Doxygen @brief/@param/@return to every function across all modules
    - Translate remaining Chinese comments in headers and source files
    - Add @file headers to files that were missing them
    - Add inline 'why' comments for hardware-specific logic
    - Improve enum and struct field documentation
    - Clean up comment formatting for consistency
    Files updated: 33 (14 headers + 18 source files + 1 test file)
    [lf_chassis.c, lf_chassis.h, lf_control.h, lf_debug_monitor.c, lf_debug_monitor.h, lf_future_hooks.c, lf_future_hooks.h, lf_led_blink.c]
2026-06-08 chore: untrack .claude/ and CLAUDE.md, track all reports files
    - Add .claude/ and CLAUDE.md to .gitignore (not for version control)
    - Remove reports/ output exclusions from .gitignore
    - Add !reports/** exception to allow binary files in reports/
    - Track 10 previously ignored report files (guidelines PDFs, presentation)
2026-06-08 docs: replace ASCII diagrams with Mermaid in README
    - Architecture: Mermaid flowchart with subgraphs for each layer
    - Control Algorithm: Mermaid flowchart showing PD+kff data flow
    - State Machine: Mermaid stateDiagram-v2 with all transitions
    Mermaid renders natively on GitHub with zoom, pan, and dark mode.
2026-06-08 docs: fix typo in README prerequisites (arm-none-eabi-gcc)
2026-06-08 docs: redesign Mermaid diagrams for clarity
    - Architecture: use block-beta for clean layered layout with 3-column grid
    - Control Algorithm: top-down flowchart showing sensor→PD→motor pipeline
    - State Machine: use composite state groups (Avoidance, Fixed Turn, Reorient)
    to reduce visual clutter, direction LR for horizontal layout
2026-06-12 docs: renumber figure generation scripts (fig8-11 → fig7-10)
    After removing the results section, figure numbering shifted down by one.
    Rename gen_fig{8,9,10,11}_*.py to gen_fig{7,8,9,10}_*.py and update
    their output filenames accordingly.
2026-06-12 docs: add all 10 regenerated figure PDFs (fig1-fig10)
    Generated from matplotlib scripts using the report's Python venv.
    Covers architecture, vehicle, timeline, sensor pipeline, control block,
    state machine, avoidance maneuver, LoRa sequence, and sweep results.
2026-06-12 docs: revise final report — de-AI language, cut redundancy, polish technical writing
    Phase 3 revision across all sections: removed AI-sounding phrases
    ("substantially", "strictly weaker", "fundamentally"), merged redundant
    paragraphs, condensed Table II from 8 to 6 rows, added missing citations
    and equation references, tightened figure captions and abstract.
2026-06-15 docs: renumber figures and add new PCB/schematic diagrams (fig3-11)
